rent-a-human/mechanical-ventilator/README.md

# mechanical-ventilator
Soporte Automatico para Emergencia Respiratoria
