rent-a-human/mechanical-ventilator/files/1.png

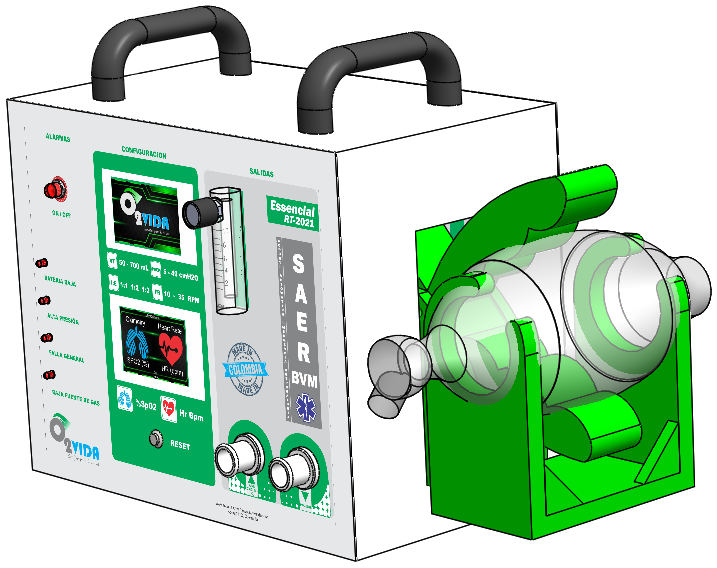
files/1.png
