rent-a-human/mechanical-ventilator/files/02 vida.png

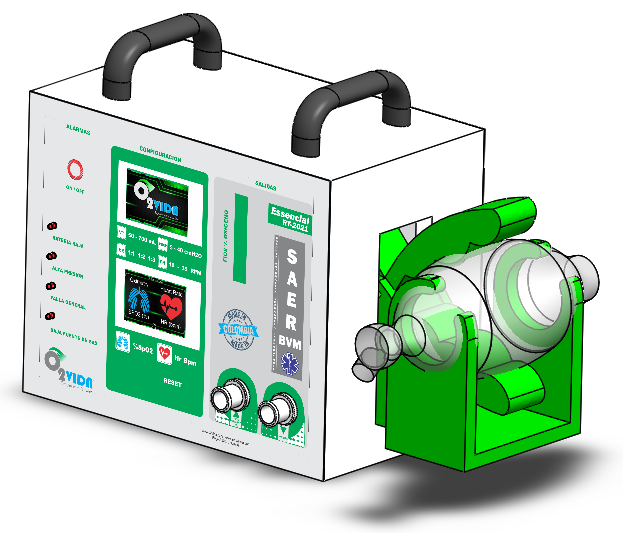
files/02 vida.png
