rent-a-human/mechanical-ventilator/files/02 vida_0.png

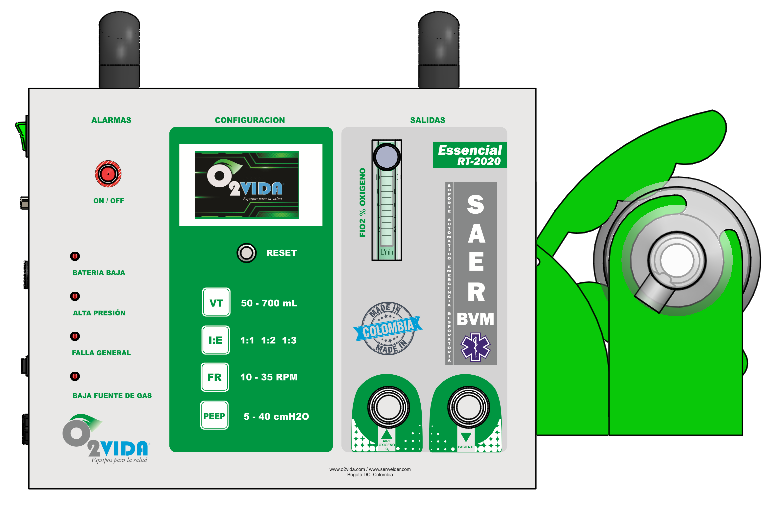
files/02 vida_0.png
