rent-a-human/mechanical-ventilator/files/02 vida_1.png

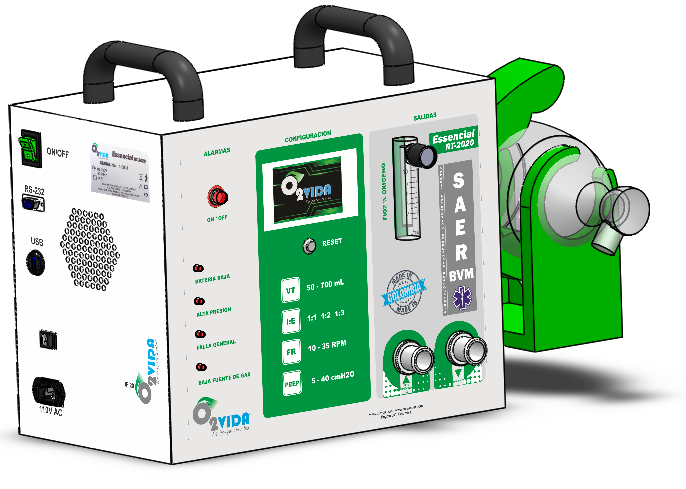
files/02 vida_1.png
