rent-a-human/mechanical-ventilator/files/02 vida_2.png

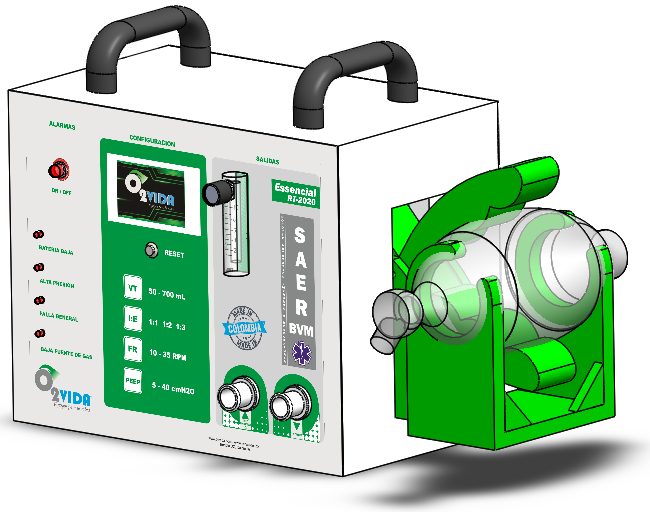
files/02 vida_2.png
