rent-a-human/mechanical-ventilator/files/2.png

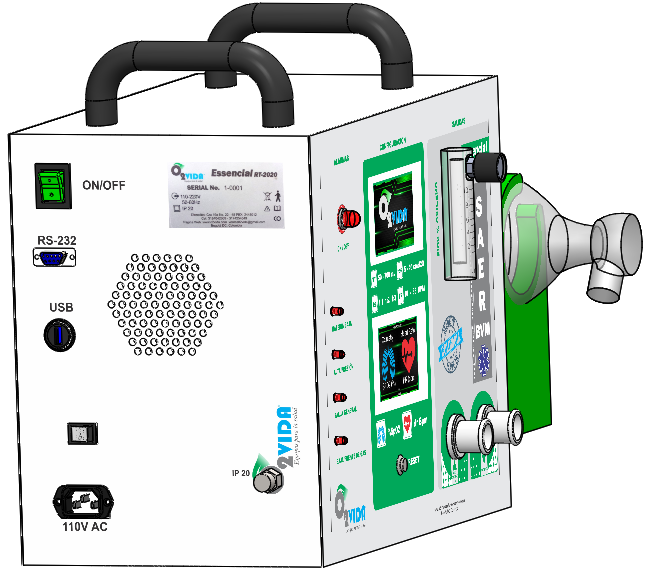
files/2.png
