rent-a-human/mechanical-ventilator/files/3.jpg

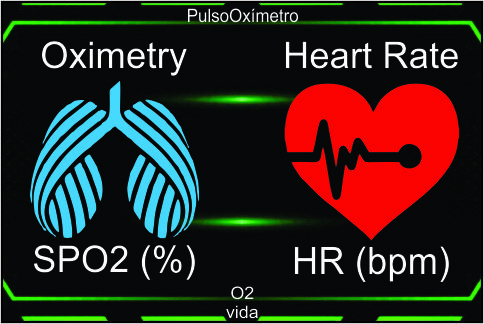
files/3.jpg
