rent-a-human/mechanical-ventilator/files/3.png

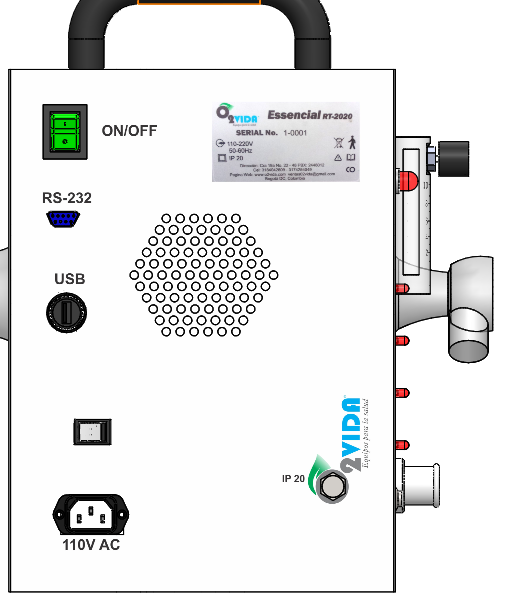
files/3.png
