rent-a-human/mechanical-ventilator/files/4.png

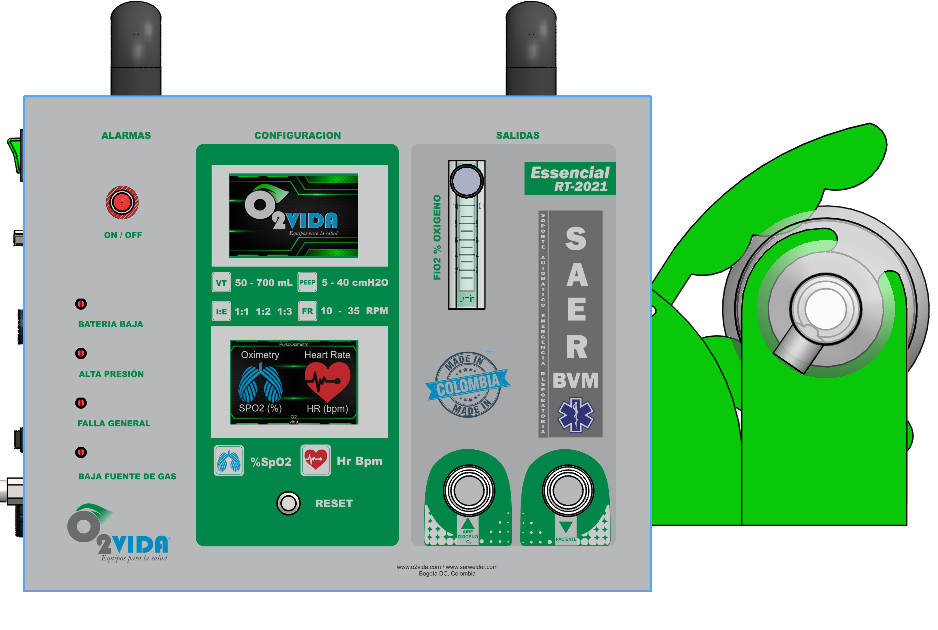
files/4.png
