rent-a-human/mechanical-ventilator/files/5.png

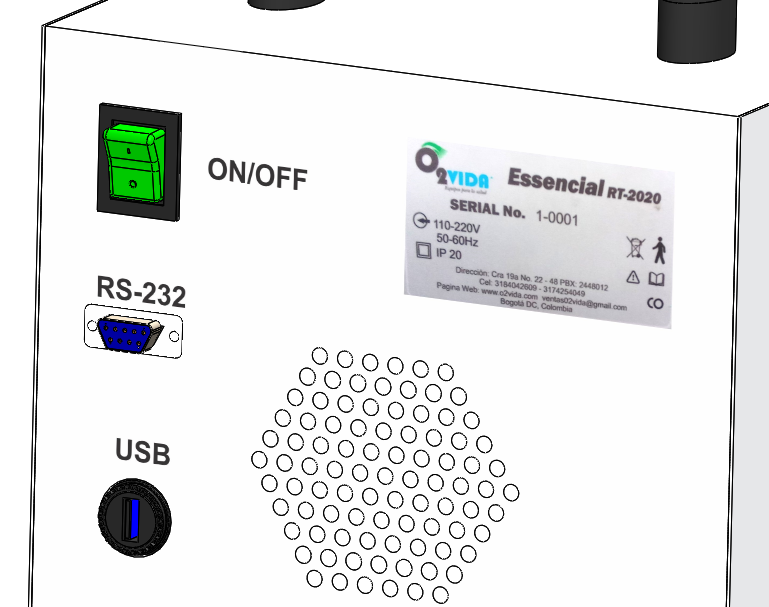
files/5.png
