rent-a-human/mechanical-ventilator/files/6.png

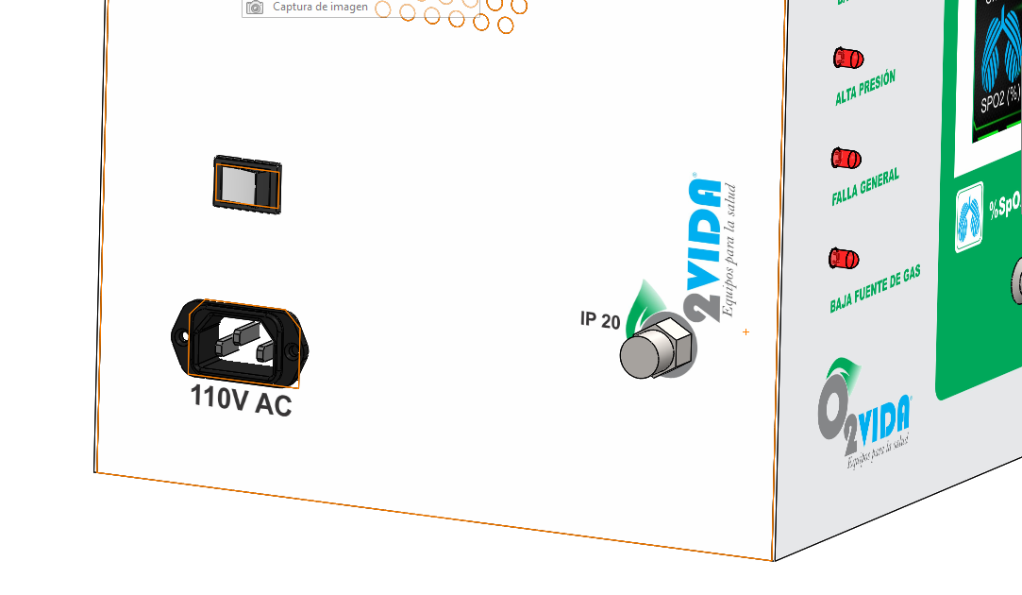
files/6.png
