rent-a-human/mechanical-ventilator/files/7.png

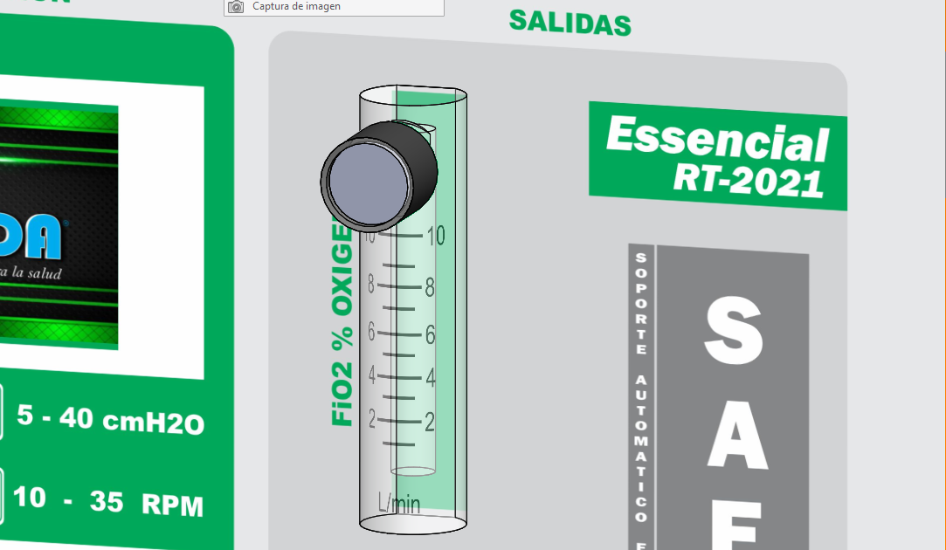
files/7.png
