rent-a-human/mechanical-ventilator/files/8.png

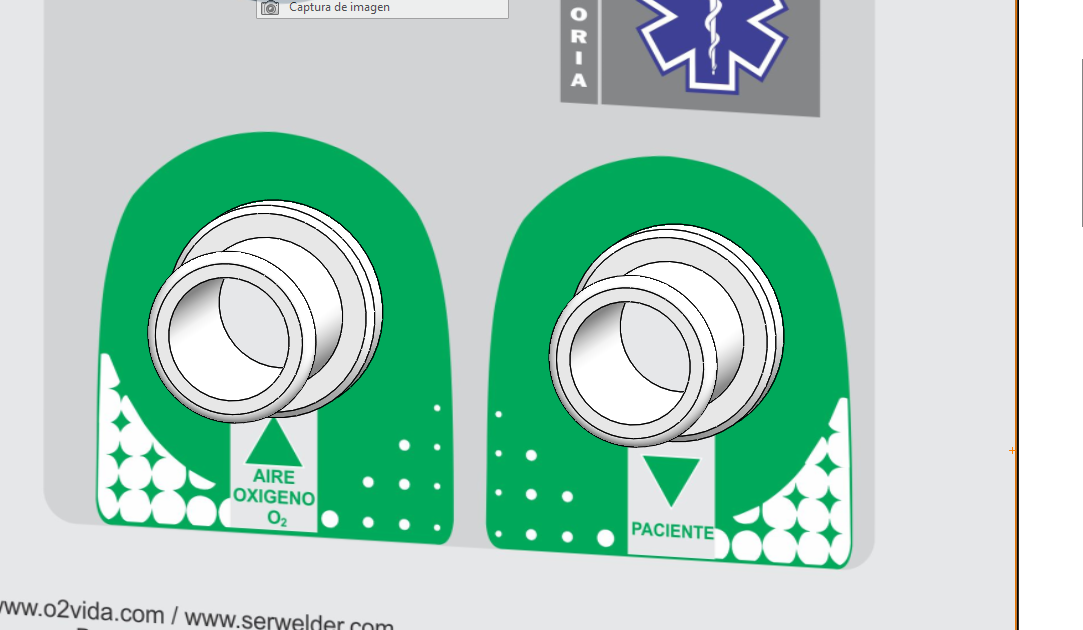
files/8.png
