rent-a-human/mechanical-ventilator/files/9.png

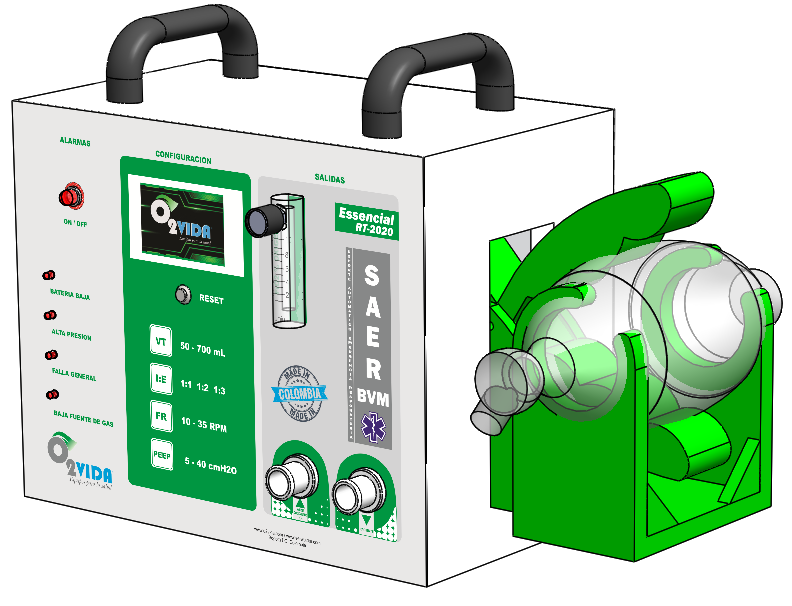
files/9.png
