rent-a-human/mechanical-ventilator/files/10.png

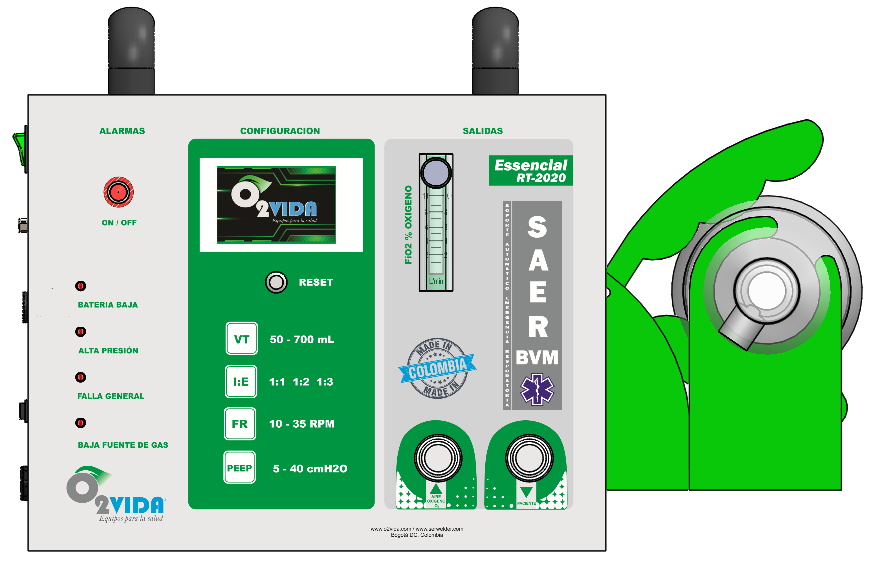
files/10.png
