rent-a-human/mechanical-ventilator/files/11.png

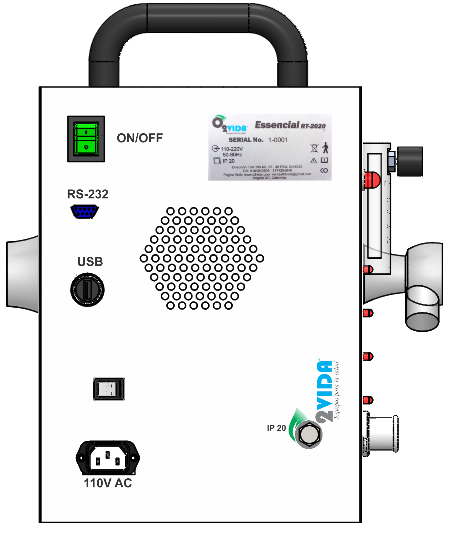
files/11.png
