rent-a-human/mechanical-ventilator/files/12.png

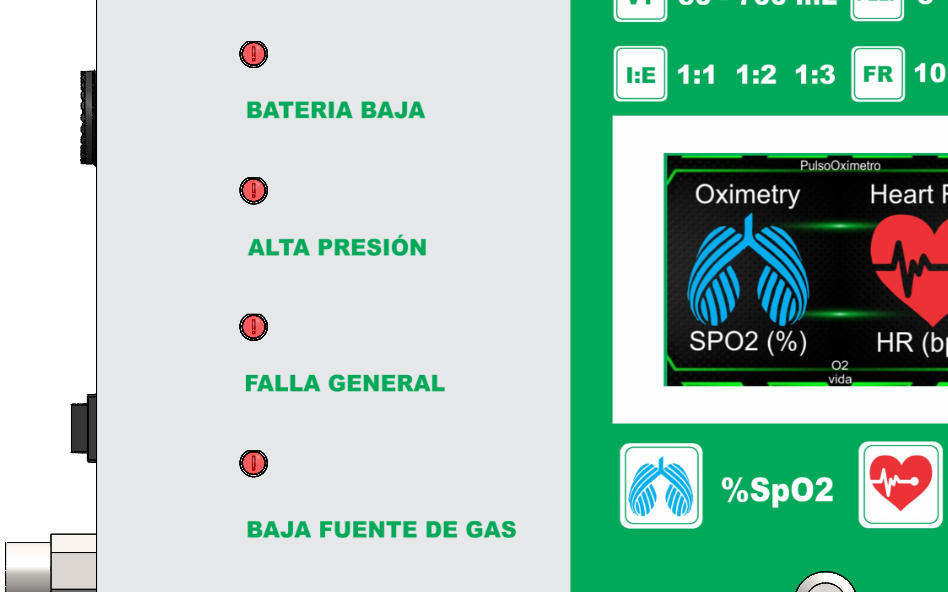
files/12.png
