rent-a-human/mechanical-ventilator/files/13.png

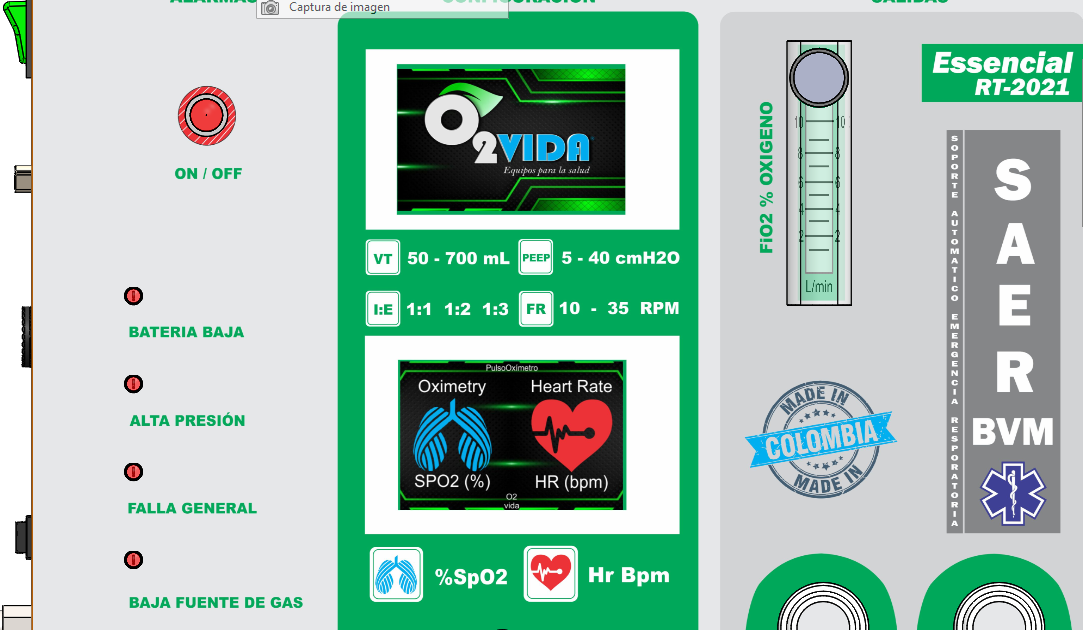
files/13.png
