rent-a-human/mechanical-ventilator/files/14.png

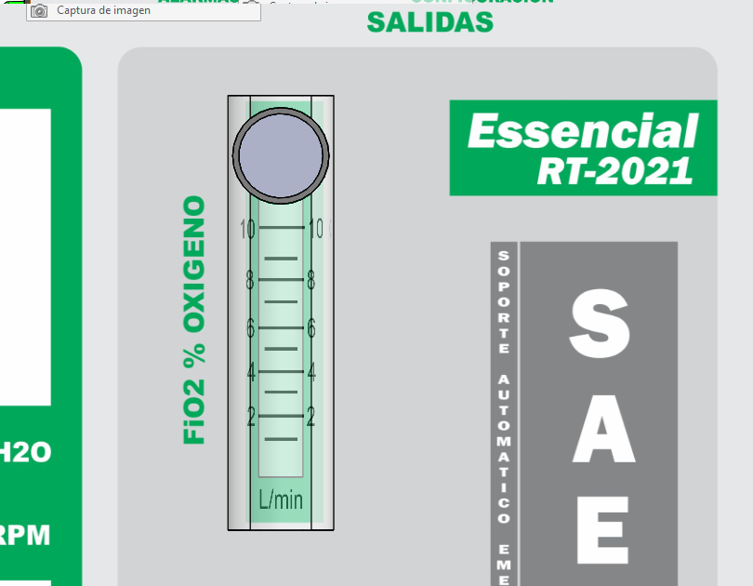
files/14.png
