rent-a-human/mechanical-ventilator/files/15.png

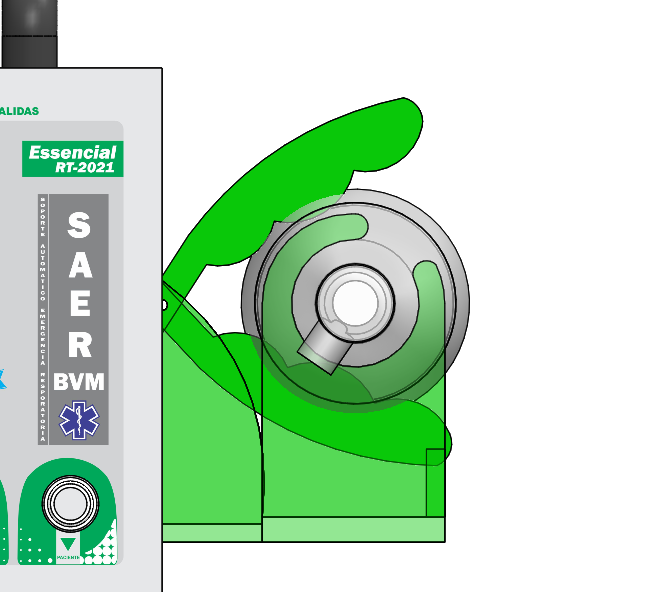
files/15.png
