rent-a-human/mechanical-ventilator/files/16.png

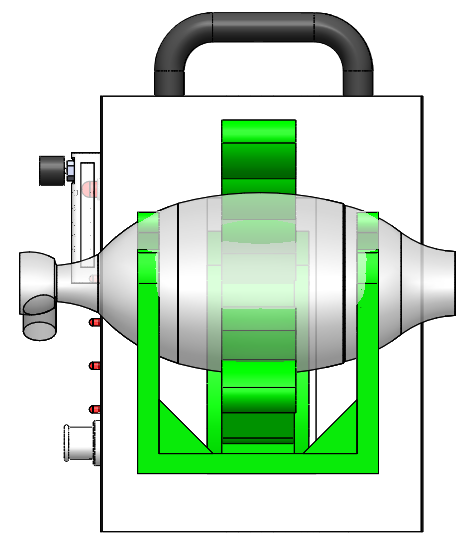
files/16.png
