rent-a-human/mechanical-ventilator/files/17.png

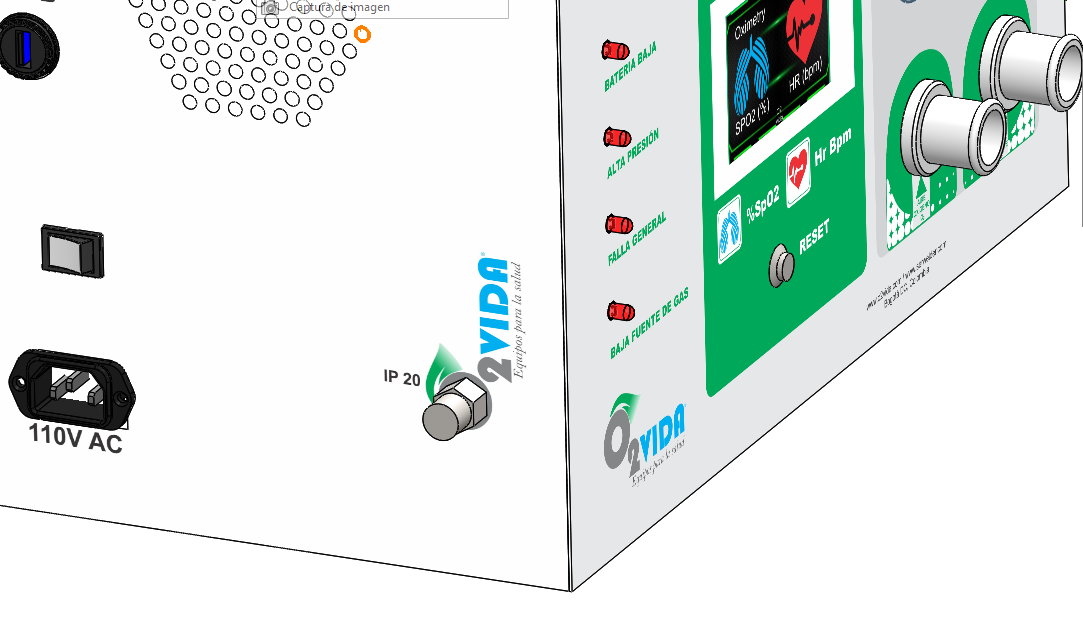
files/17.png
