rent-a-human/mechanical-ventilator/files/back1.png

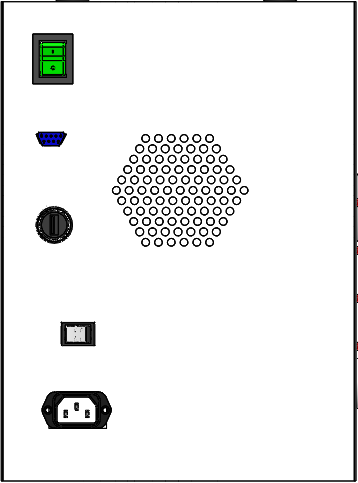
files/back1.png
