rent-a-human/mechanical-ventilator/files/frente_2.jpg

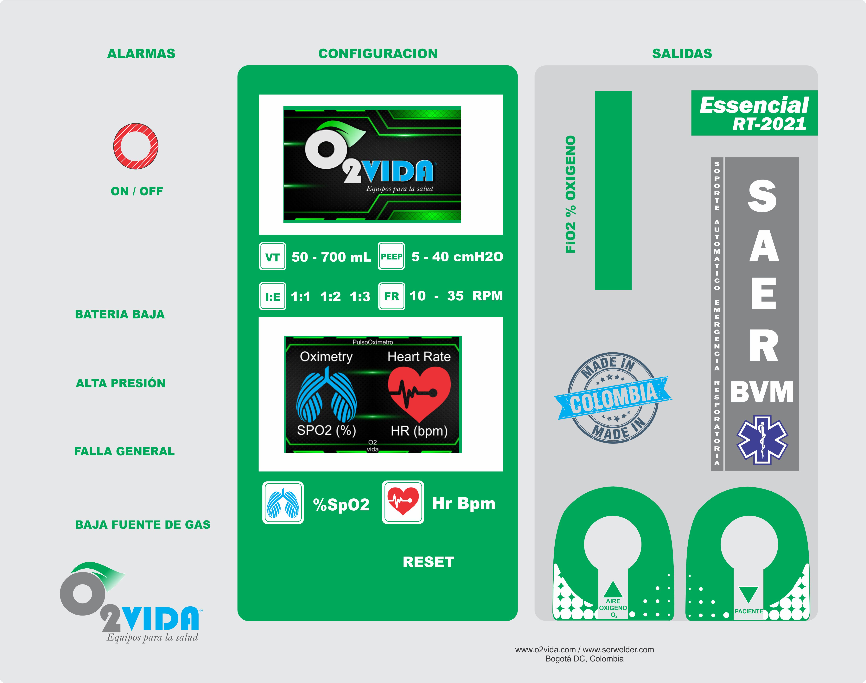
files/frente_2.jpg
