rent-a-human/mechanical-ventilator/files/frente_B.jpg

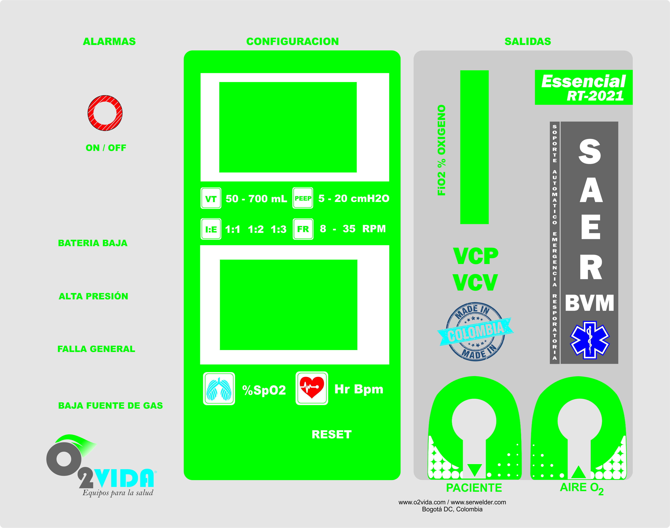
files/frente_B.jpg
