rent-a-human/mechanical-ventilator/files/RESPIRADOR/planos tarjeta/adelante2.PNG

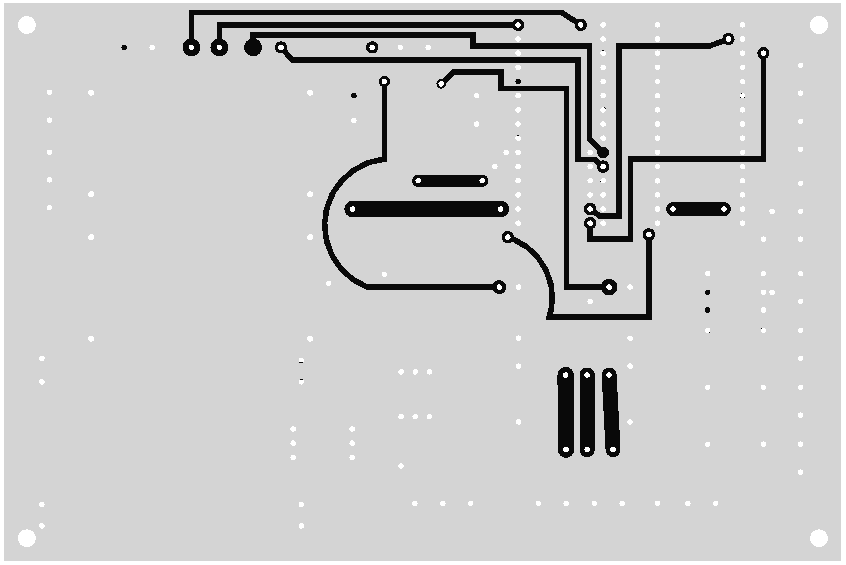
files/RESPIRADOR/planos tarjeta/adelante2.PNG
