rent-a-human/mechanical-ventilator/files/RESPIRADOR/planos tarjeta/atras_jpg.JPG

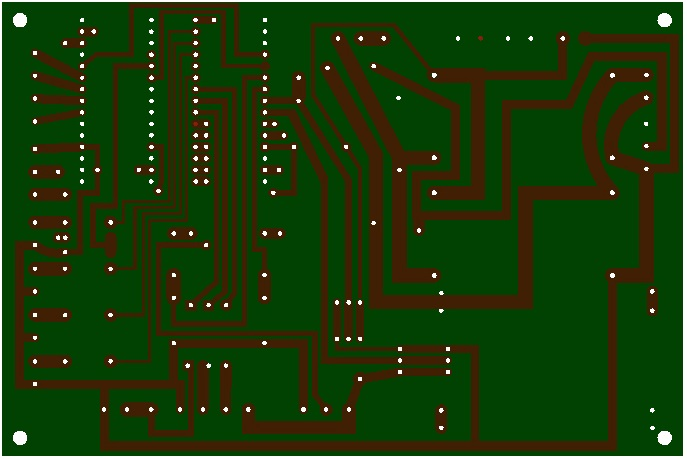
files/RESPIRADOR/planos tarjeta/atras_jpg.JPG
