rent-a-human/mechanical-ventilator/files/RESPIRADOR/planos tarjeta/atras_solo.PNG

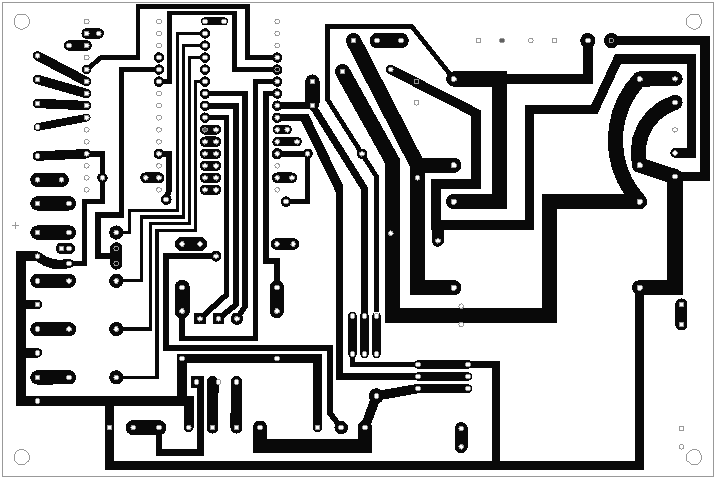
files/RESPIRADOR/planos tarjeta/atras_solo.PNG
