rent-a-human/mechanical-ventilator/files/ROTA1.png

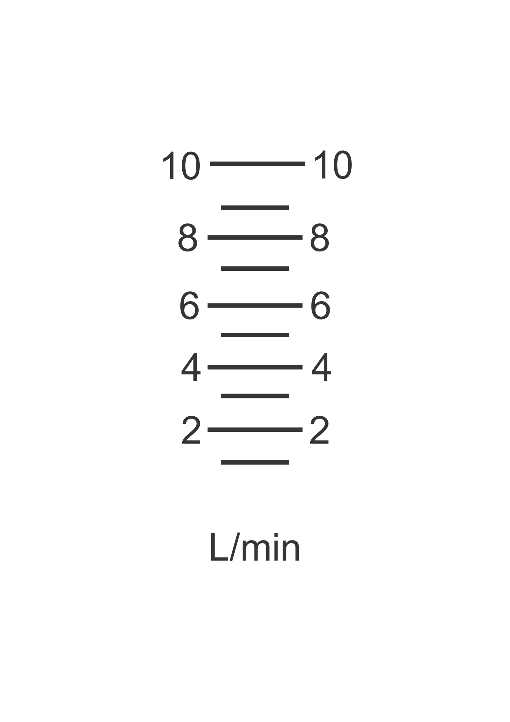
files/ROTA1.png
