rent-a-human/mechanical-ventilator/files/rotametro.jpg

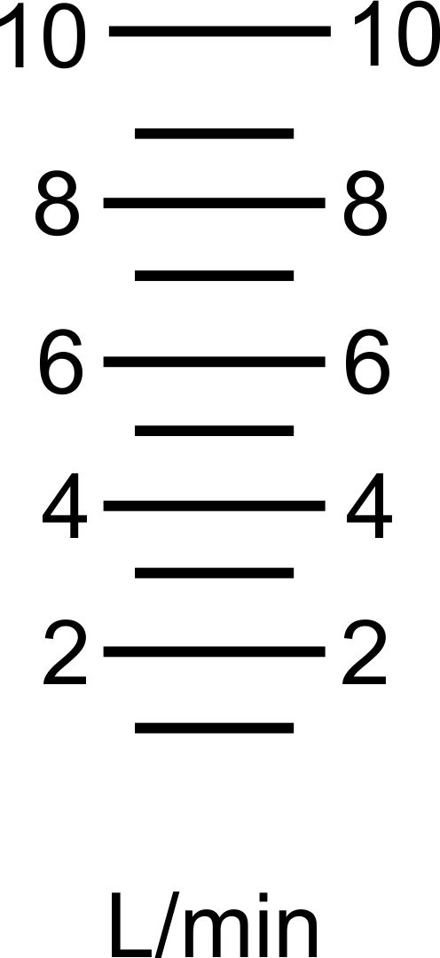
files/rotametro.jpg
