rent-a-human/mechanical-ventilator/files/On off switch.SLDASM

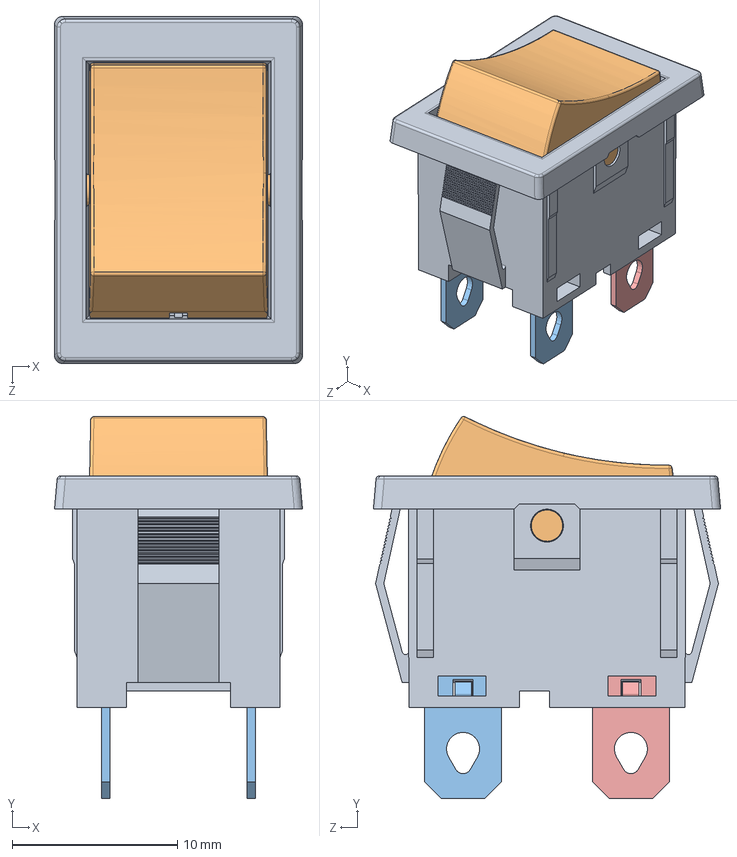
[picture p35: CAD file, 2021-10-17]
files/On off switch.SLDASM
15.0 x 23.1 x 21.0 mm
On off switch base
On off switch button
On off switch pin2 x 2
On off switch pin1
On off switch pin3
On off switch click
On off switch spring
