rent-a-human/mechanical-ventilator/files/Ensamblaje1.SLDASM

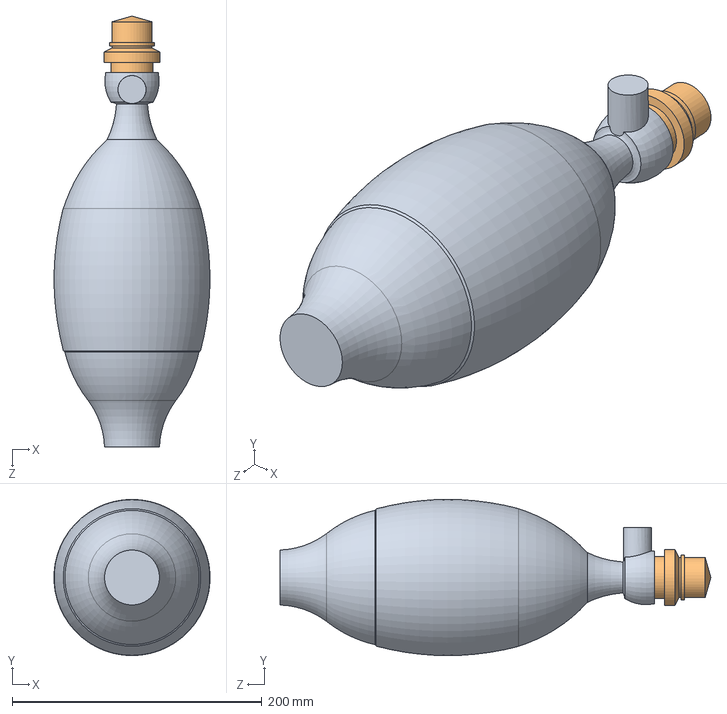
[picture p36: CAD file, 2021-10-17]
files/Ensamblaje1.SLDASM
124.9 x 125.1 x 345.0 mm
ambu
peep
