rent-a-human/mechanical-ventilator/files/Ensamblaje_Respirador_1_pantalla.SLDASM

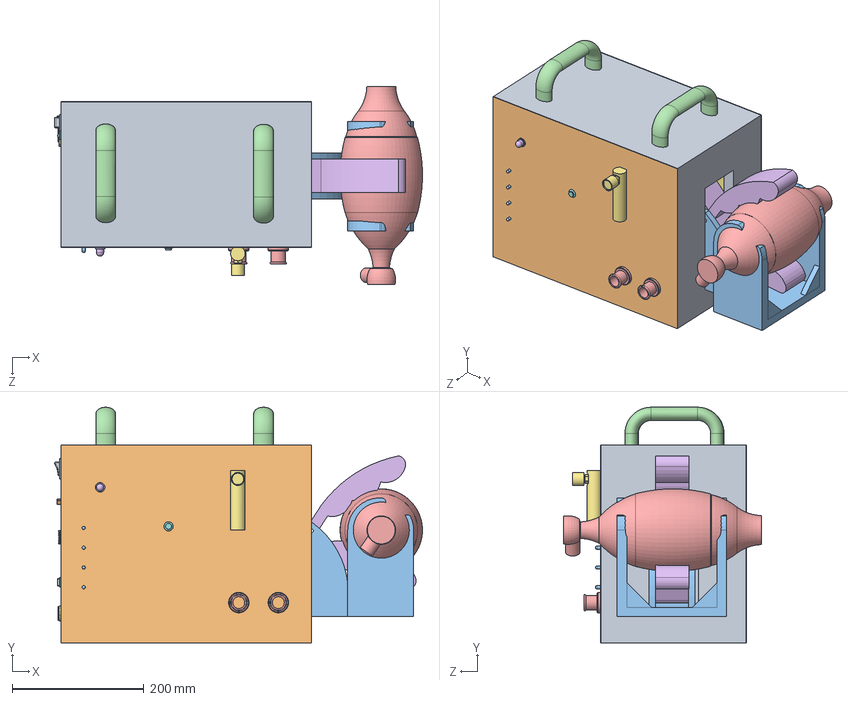
[picture p37: CAD file, 2021-10-17]
files/Ensamblaje_Respirador_1_pantalla.SLDASM
558.3 x 357.5 x 300.0 mm
cajon
tapa_1
base_ambu
manija x 2
ambu
pinza x 2
tapa
On off switch base
On off switch button
On off switch pin2 x 2
On off switch pin1
On off switch pin3
On off switch click
On off switch spring
AC Male Socket PC v7
USB3 FTV 2X_ USB TYPE
KCD4_ROCKET_SWITCH
RS232 Female
LED5mmBody x 4
LED5mmLeg x 4
Acople x 2
piloto
ROTAMETRO
reset_buton
