rent-a-human/mechanical-ventilator/files/Ensamblaje_Pinza_Motores.SLDASM

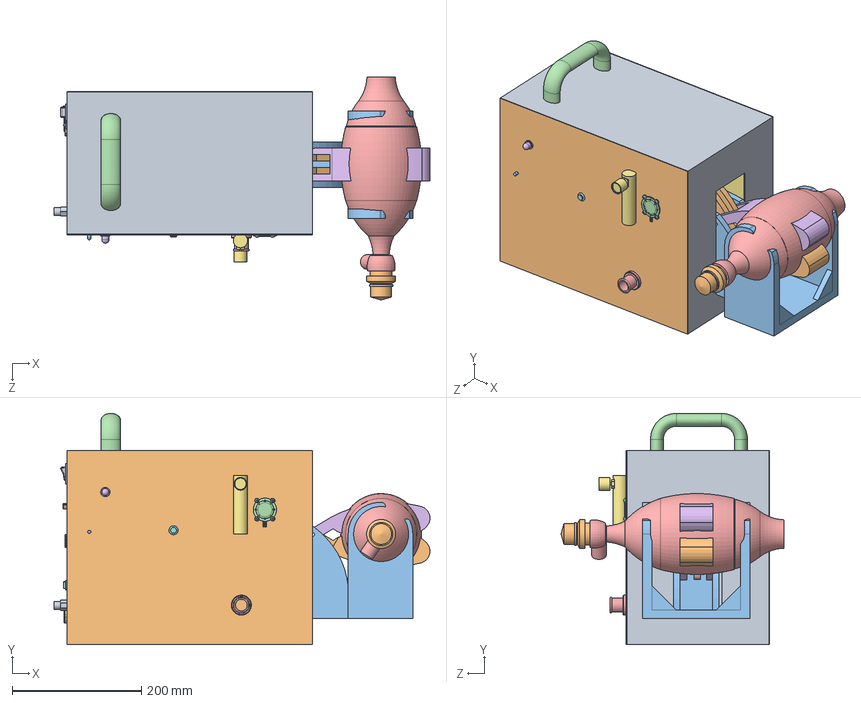
[picture p38: CAD file, 2021-10-17]
files/Ensamblaje_Pinza_Motores.SLDASM
581.6 x 357.5 x 345.0 mm
base_ambu
pinza
Soporte Biela Tuerca
Biela x 2
42BYGH0425 x 2
8mm ID 10mm OD Lead Screw
Trapezoidal lead screw 90mm
acople flexible x 2
pinza inferior
