rent-a-human/mechanical-ventilator/files/RESPIRADOR/planos tarjeta/atras_y_adelante.DXF

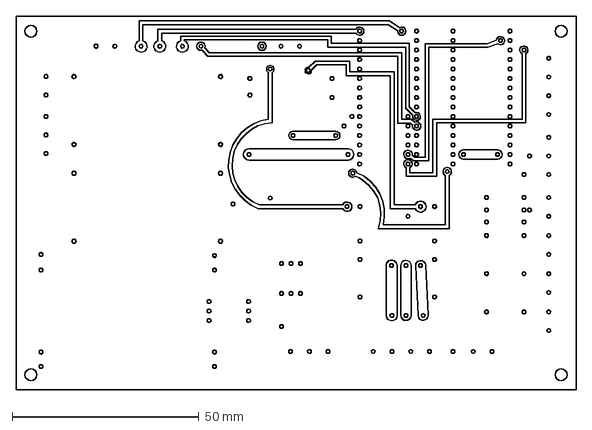
[picture p39: CAD file, 2021-10-17]
files/RESPIRADOR/planos tarjeta/atras_y_adelante.DXF
150.0 x 100.0 mm
