rent-a-human/mechanical-ventilator/files/Manguera Filtro Mascara.SLDPRT

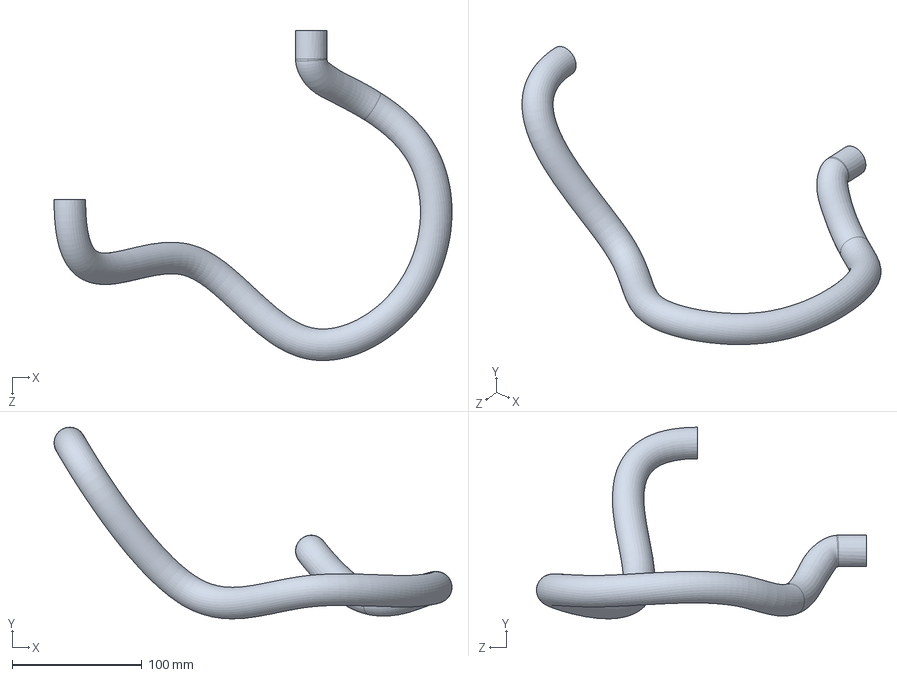
[picture p40: CAD file, 2021-10-17]
files/Manguera Filtro Mascara.SLDPRT
306.5 x 147.6 x 254.2 mm
