rent-a-human/mechanical-ventilator/files/RESPIRADOR/planos tarjeta/baquela.DXF

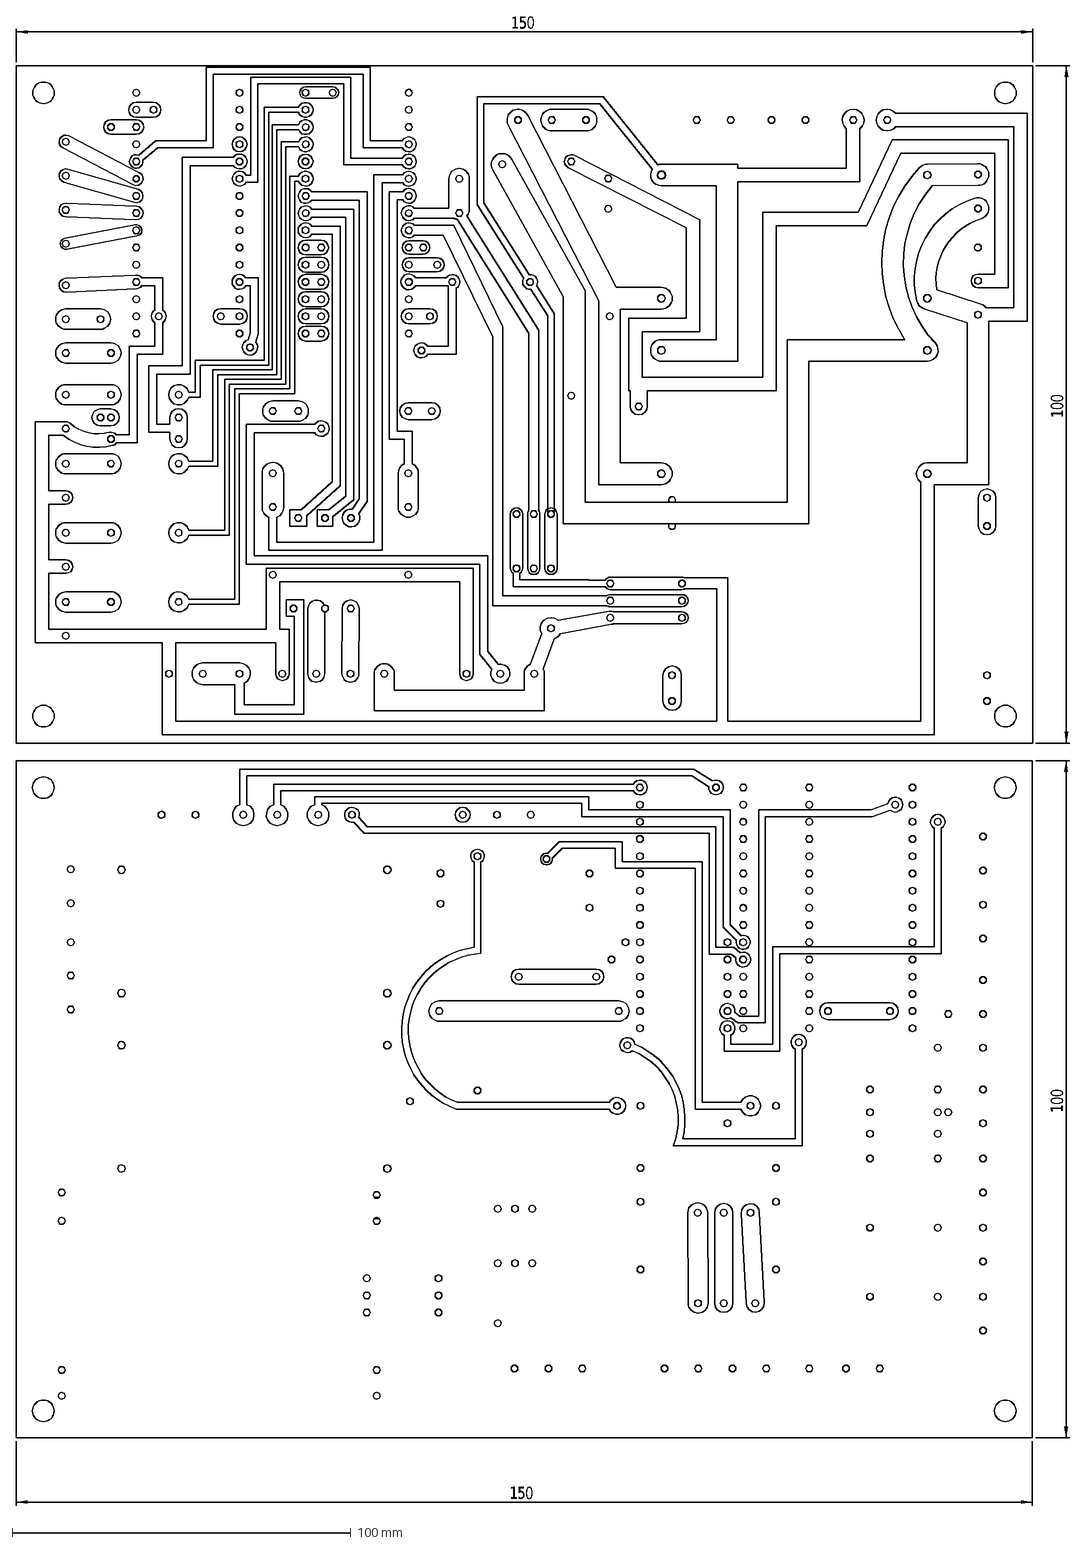
[picture p41: CAD file, 2021-10-17]
files/RESPIRADOR/planos tarjeta/baquela.DXF
150
100
