rent-a-human/mechanical-ventilator/files/conector_o2.SLDPRT

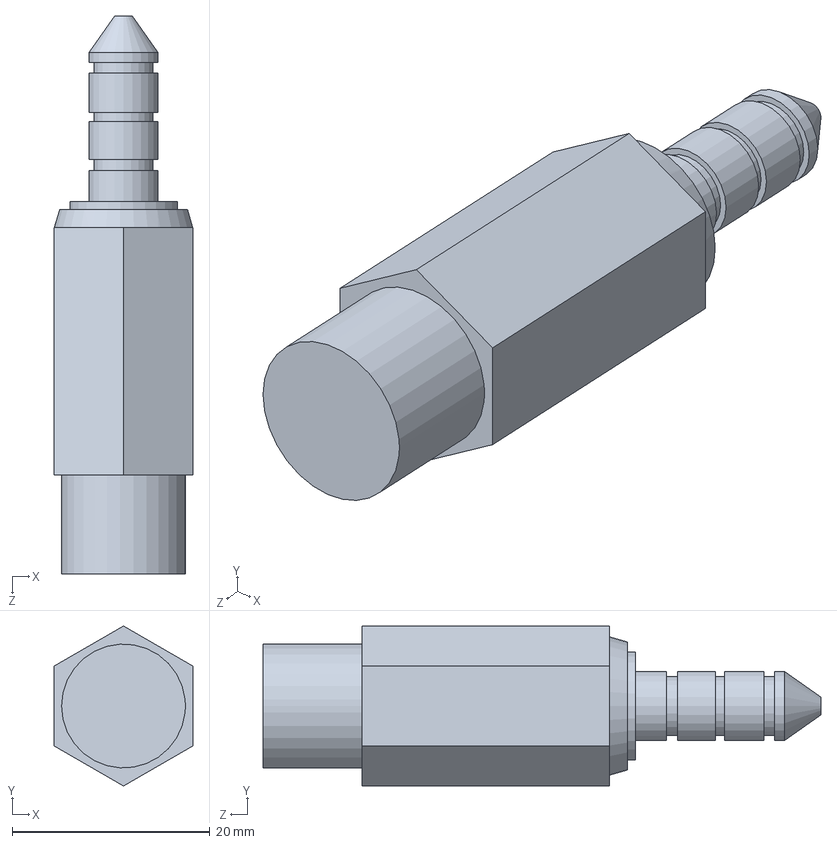
[picture p42: CAD file, 2021-10-17]
files/conector_o2.SLDPRT
14.0 x 16.2 x 56.4 mm
