rent-a-human/mechanical-ventilator/files/Manguera Filtro Mascara Paciente 2.SLDPRT

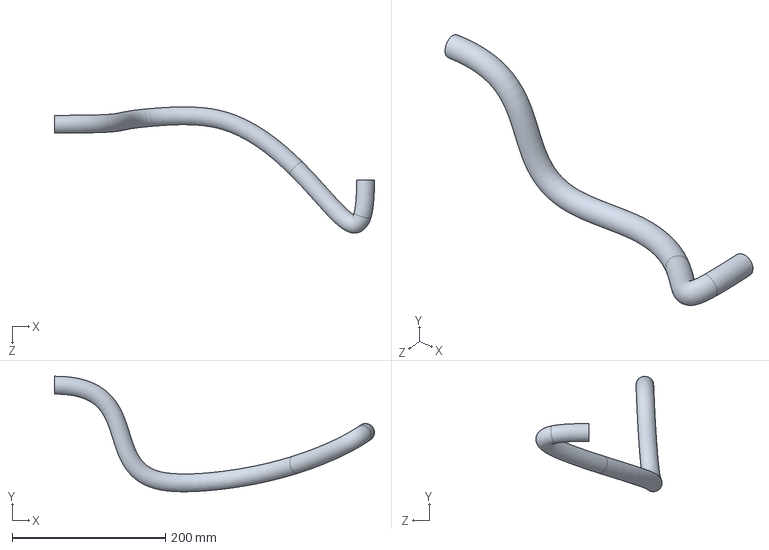
[picture p43: CAD file, 2021-10-17]
files/Manguera Filtro Mascara Paciente 2.SLDPRT
417.6 x 150.8 x 164.8 mm
