rent-a-human/mechanical-ventilator/files/Sensor_Pesion.SLDPRT

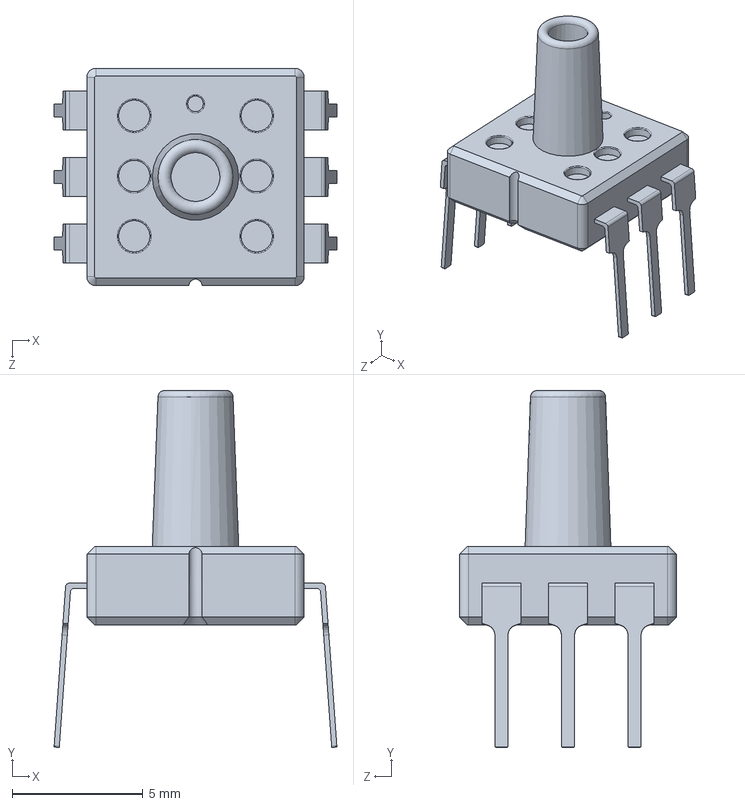
[picture p44: CAD file, 2021-10-17]
files/Sensor_Pesion.SLDPRT
10.8 x 13.6 x 8.30 mm
