rent-a-human/mechanical-ventilator/files/tapa.SLDPRT

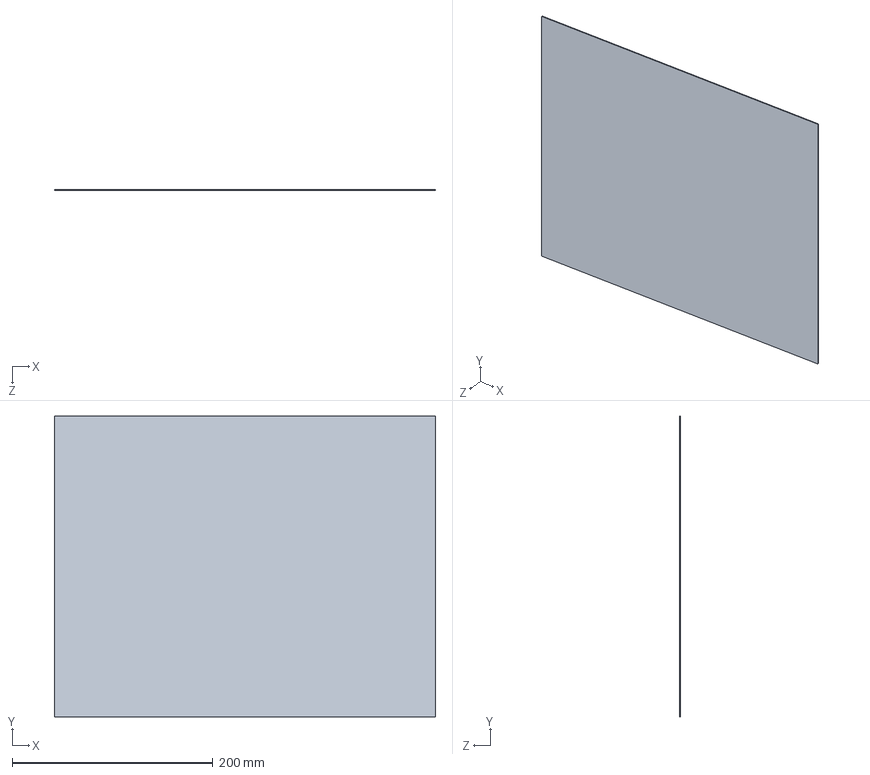
[picture p45: CAD file, 2021-10-17]
files/tapa.SLDPRT
380.0 x 300.0 x 1.00 mm
