rent-a-human/mechanical-ventilator/files/Mascara.SLDPRT

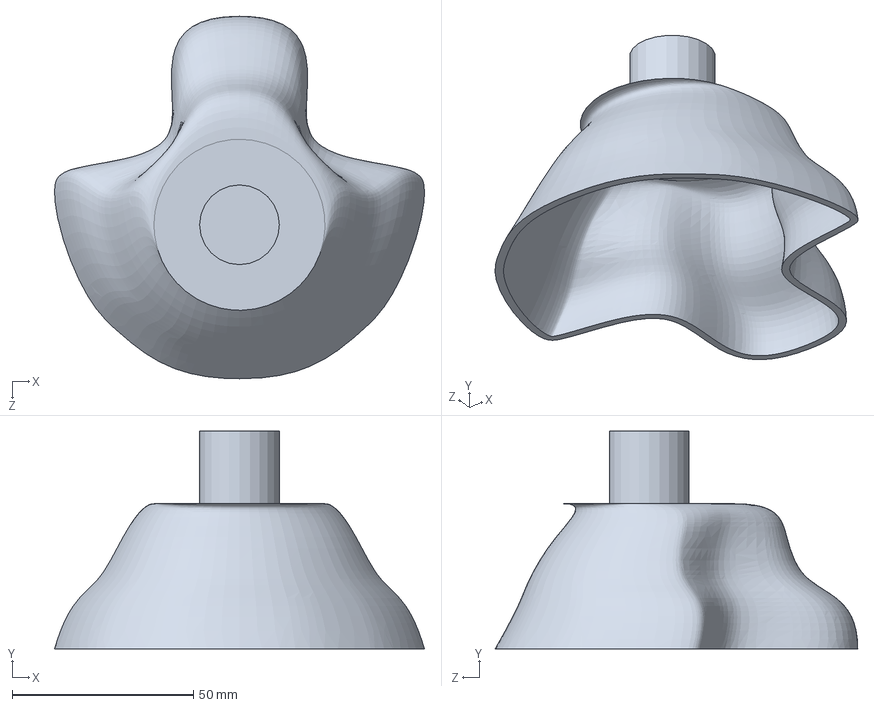
[picture p46: CAD file, 2021-10-17]
files/Mascara.SLDPRT
102.1 x 60.0 x 100.0 mm
