rent-a-human/mechanical-ventilator/files/Manguera_2_O2_2.SLDPRT

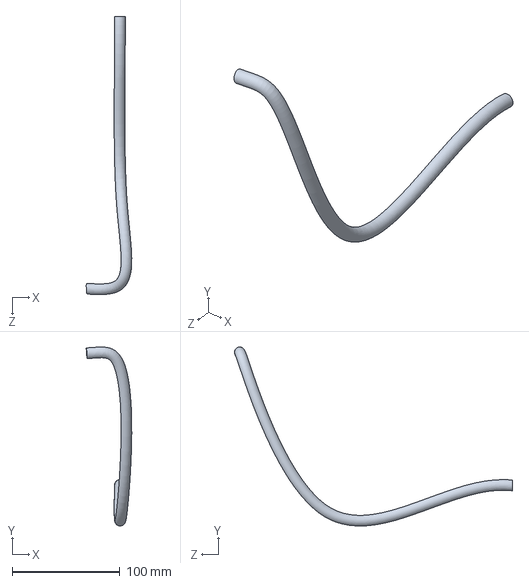
[picture p47: CAD file, 2021-10-17]
files/Manguera_2_O2_2.SLDPRT
42.3 x 166.4 x 258.6 mm
