rent-a-human/mechanical-ventilator/files/peep.SLDPRT

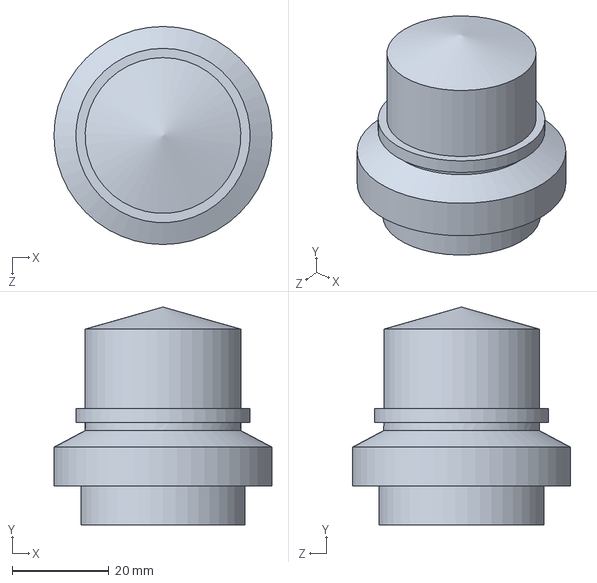
[picture p48: CAD file, 2021-10-17]
files/peep.SLDPRT
45.0 x 45.0 x 45.0 mm
