rent-a-human/mechanical-ventilator/files/conector_o2_out.SLDPRT

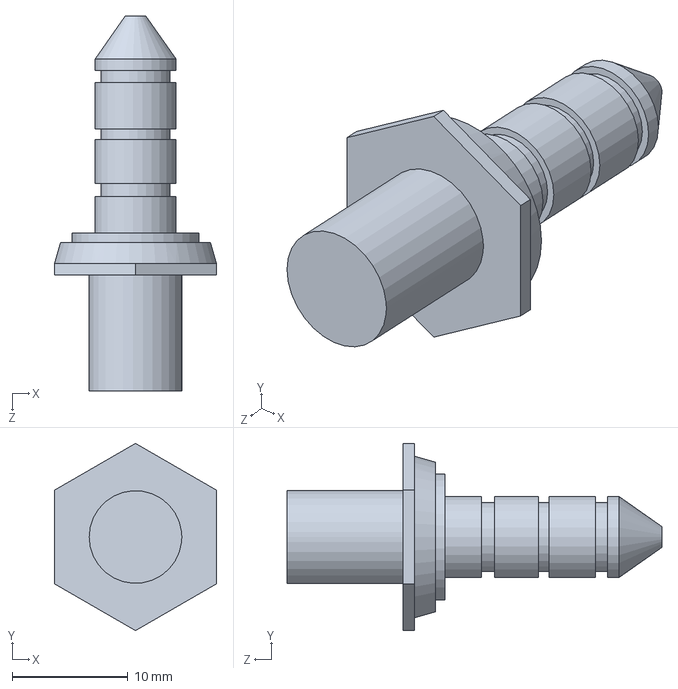
[picture p49: CAD file, 2021-10-17]
files/conector_o2_out.SLDPRT
14.0 x 16.2 x 32.4 mm
