rent-a-human/mechanical-ventilator/files/Filtro de Aire.SLDPRT

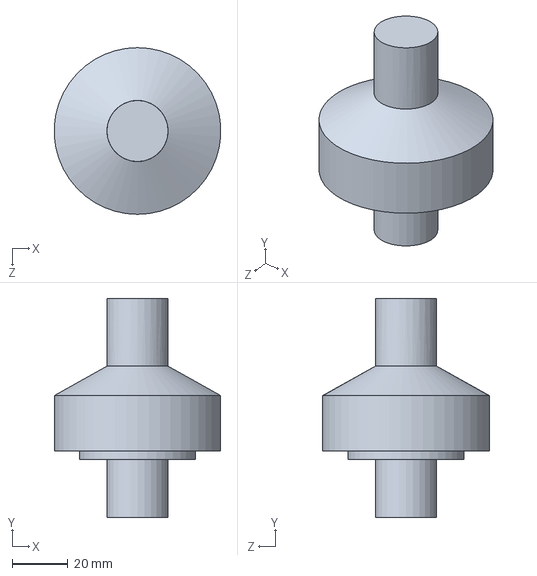
[picture p50: CAD file, 2021-10-17]
files/Filtro de Aire.SLDPRT
59.9 x 78.8 x 60.0 mm
