rent-a-human/mechanical-ventilator/files/Manguera_02_Externa.SLDPRT

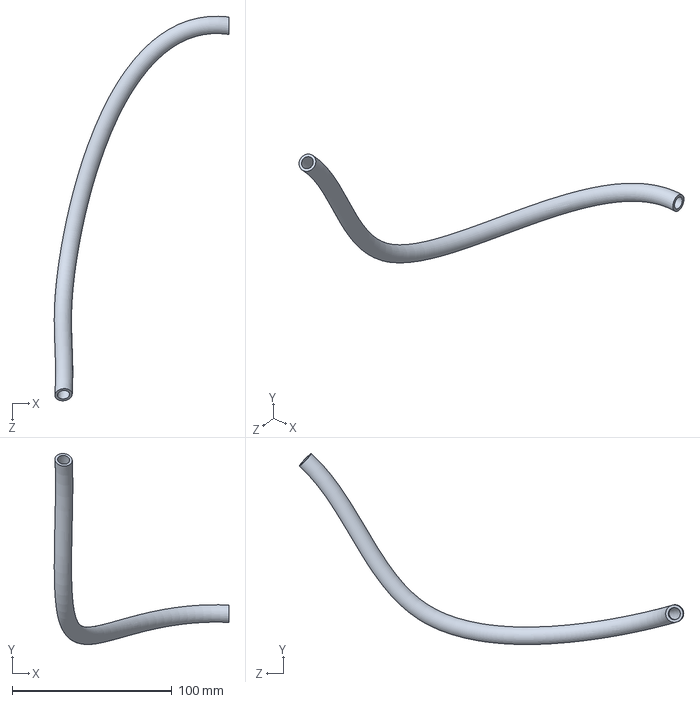
[picture p51: CAD file, 2021-10-17]
files/Manguera_02_Externa.SLDPRT
109.2 x 119.5 x 240.5 mm
