rent-a-human/mechanical-ventilator/files/pinza.SLDPRT

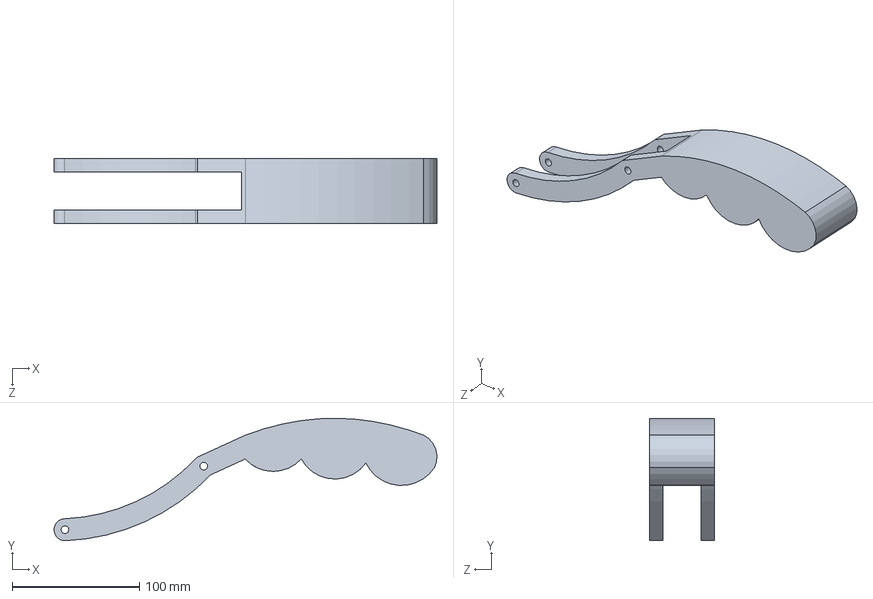
[picture p52: CAD file, 2021-10-17]
files/pinza.SLDPRT
301.1 x 96.2 x 51.0 mm
