rent-a-human/mechanical-ventilator/files/Biela.SLDPRT

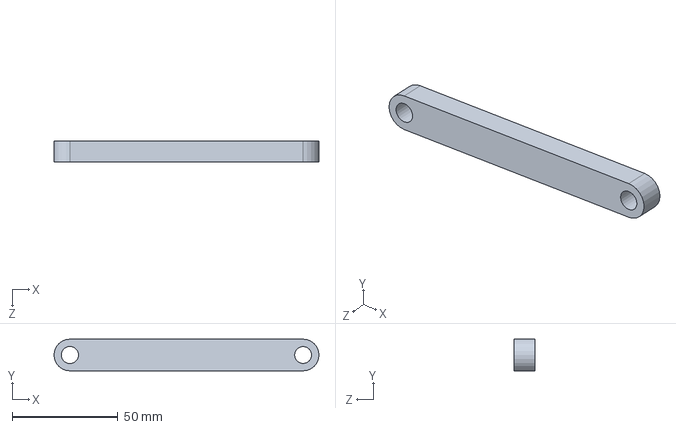
[picture p53: CAD file, 2021-10-17]
files/Biela.SLDPRT
125.0 x 15.0 x 10.0 mm
