rent-a-human/mechanical-ventilator/files/Base.SLDPRT

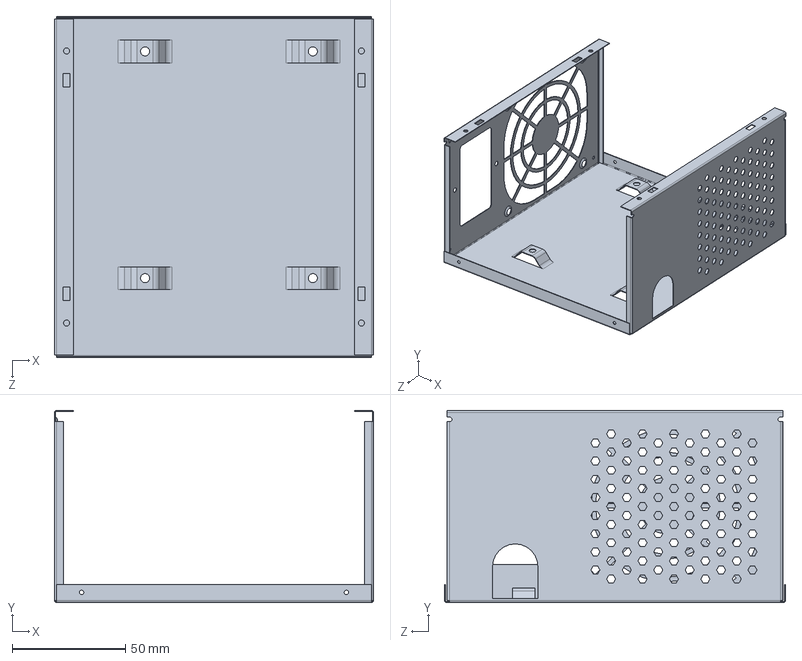
[picture p54: CAD file, 2021-10-17]
files/Base.SLDPRT
140.8 x 84.8 x 150.4 mm
