rent-a-human/mechanical-ventilator/files/piloto.SLDPRT

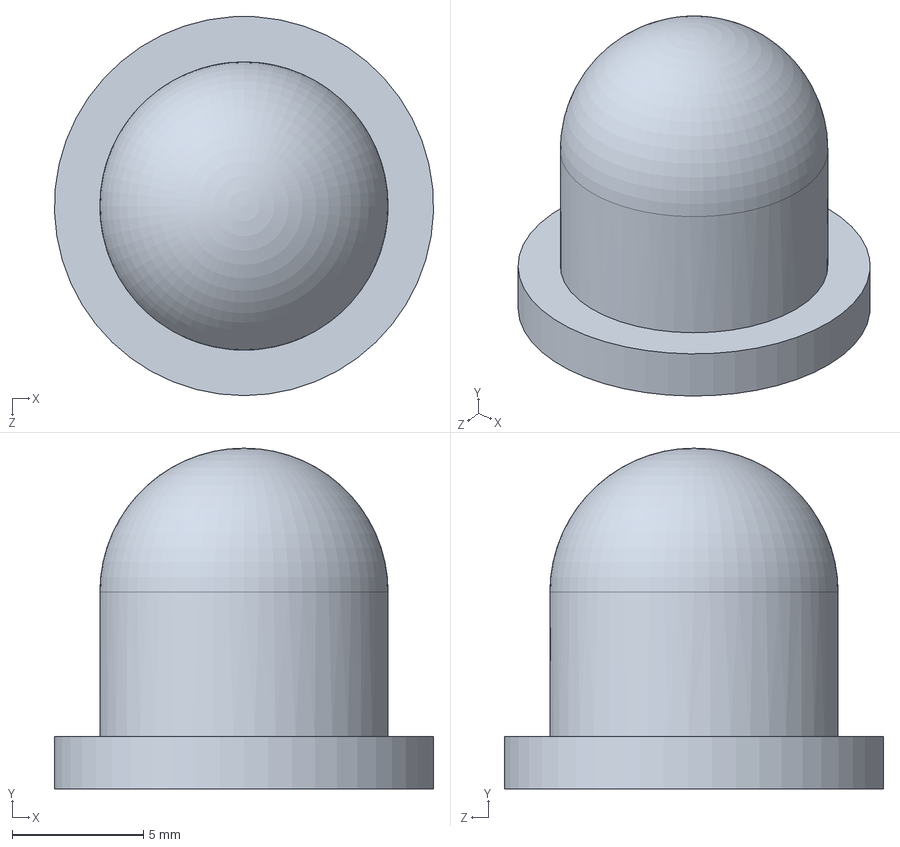
[picture p55: CAD file, 2021-10-17]
files/piloto.SLDPRT
14.5 x 13.0 x 14.5 mm
