rent-a-human/mechanical-ventilator/files/Manguera_2_O2.SLDPRT

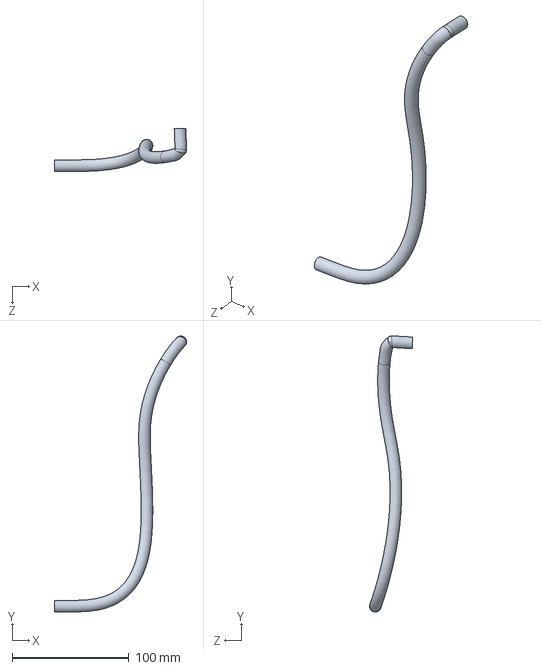
[picture p56: CAD file, 2021-10-17]
files/Manguera_2_O2.SLDPRT
113.5 x 236.8 x 36.9 mm
