rent-a-human/mechanical-ventilator/files/cajon.SLDPRT

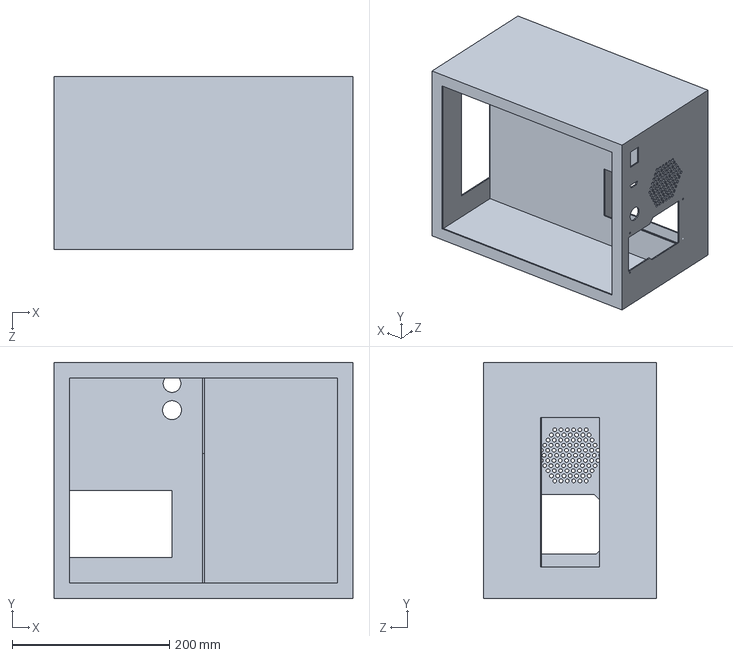
[picture p57: CAD file, 2021-10-17]
files/cajon.SLDPRT
380.0 x 300.0 x 220.0 mm
