rent-a-human/mechanical-ventilator/files/Manguera_2.sldprt

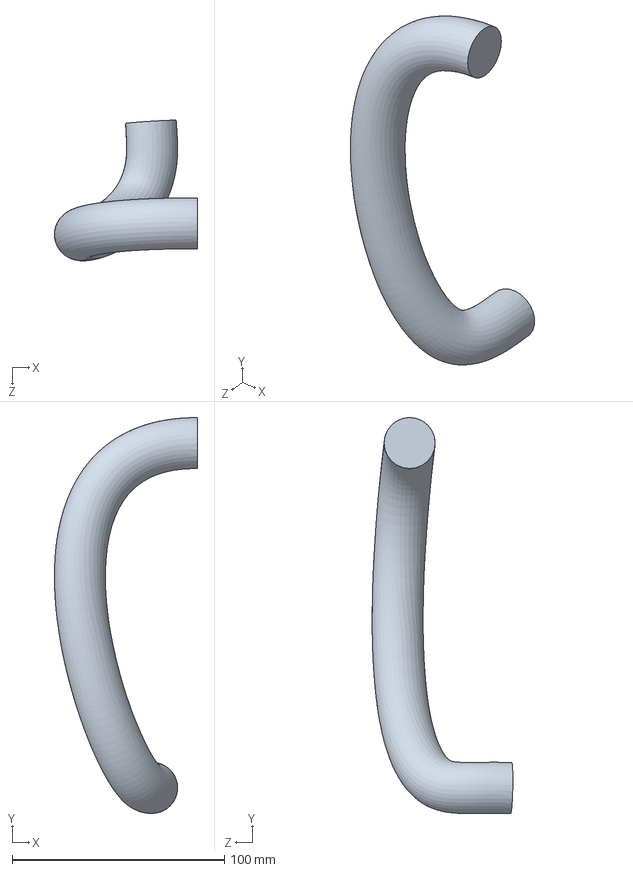
[picture p58: CAD file, 2021-10-17]
files/Manguera_2.sldprt
67.5 x 186.7 x 66.4 mm
