rent-a-human/mechanical-ventilator/files/Reservorio.SLDPRT

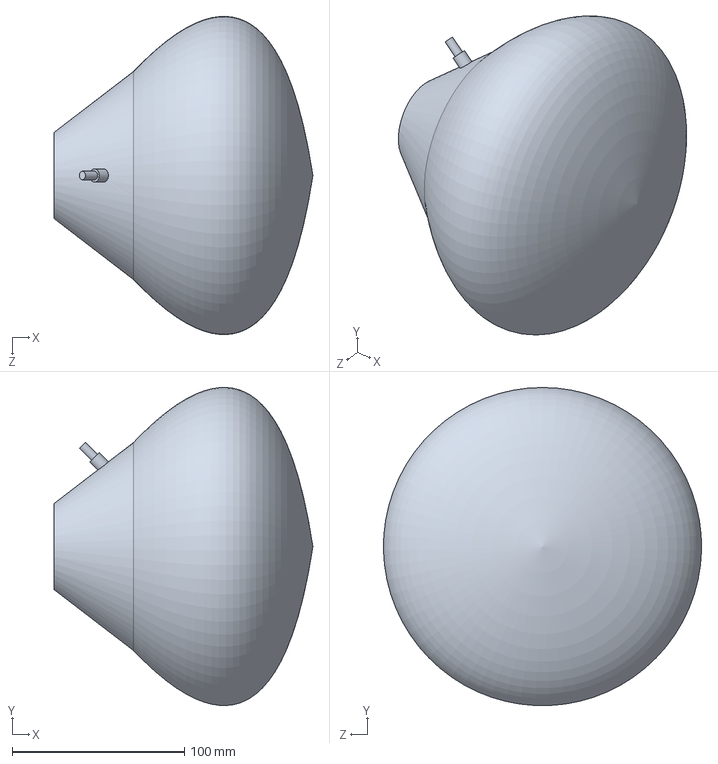
[picture p59: CAD file, 2021-10-17]
files/Reservorio.SLDPRT
150.2 x 184.5 x 184.6 mm
