rent-a-human/mechanical-ventilator/files/Acople.SLDPRT

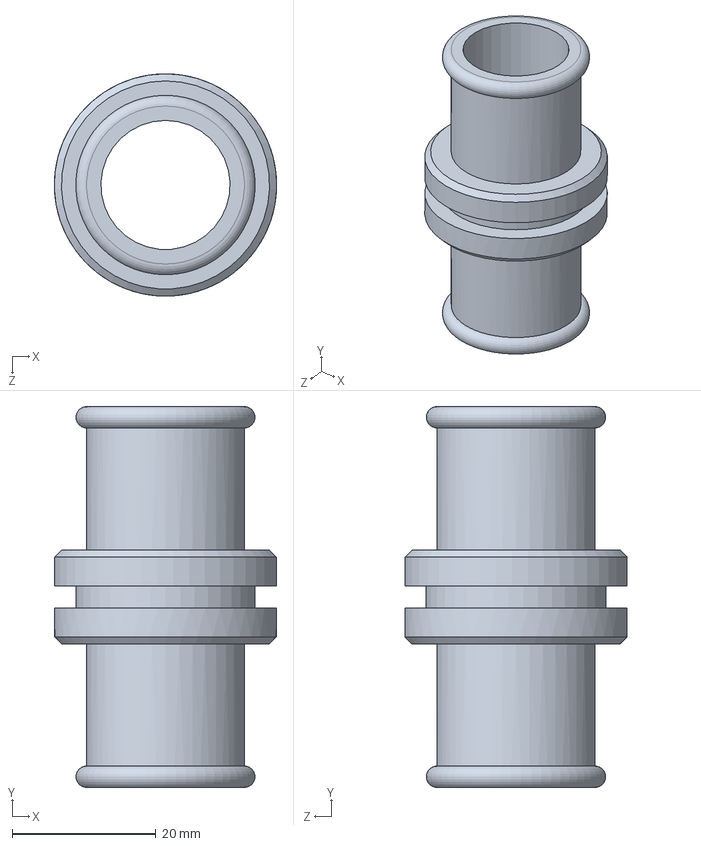
[picture p60: CAD file, 2021-10-17]
files/Acople.SLDPRT
31.0 x 53.1 x 31.0 mm
