rent-a-human/mechanical-ventilator/files/Soporte Biela Tuerca.SLDPRT

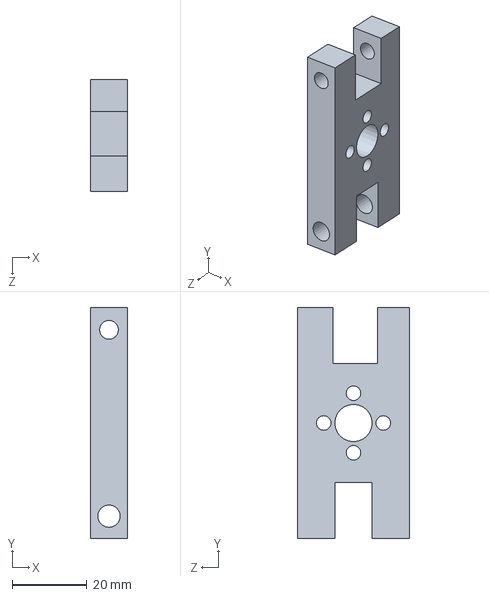
[picture p61: CAD file, 2021-10-17]
files/Soporte Biela Tuerca.SLDPRT
10.0 x 62.0 x 30.0 mm
