rent-a-human/mechanical-ventilator/files/ROTAMETRO.SLDPRT

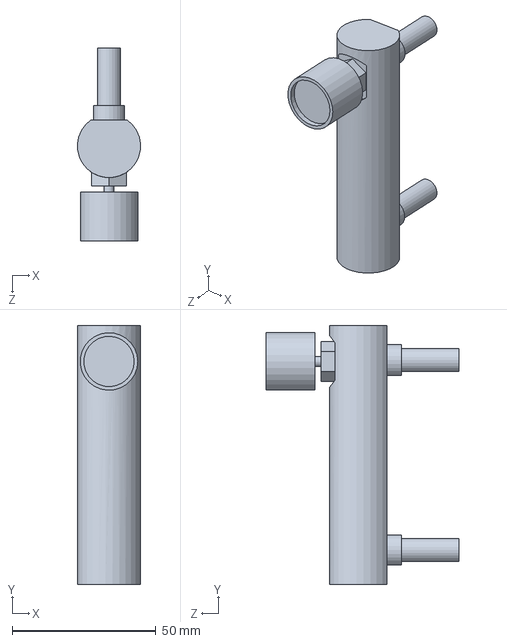
[picture p62: CAD file, 2021-10-17]
files/ROTAMETRO.SLDPRT
21.9 x 90.0 x 67.0 mm
