rent-a-human/mechanical-ventilator/files/base_ambu.SLDPRT

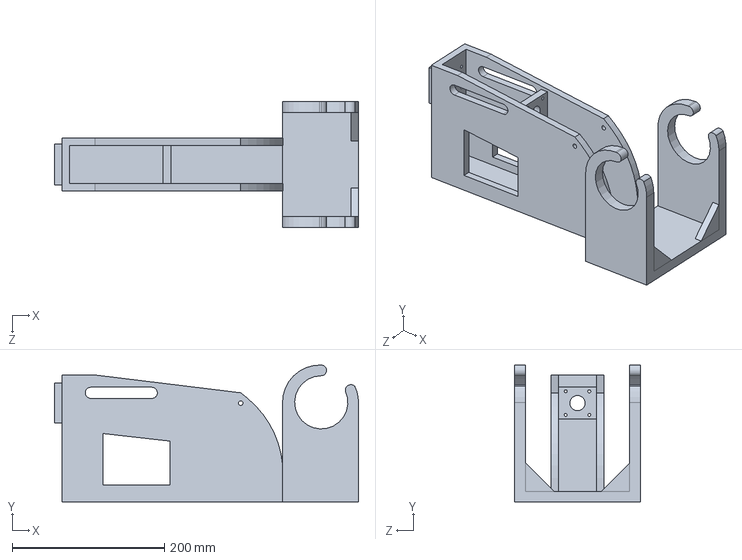
[picture p63: CAD file, 2021-10-17]
files/base_ambu.SLDPRT
400.0 x 180.0 x 166.0 mm
