rent-a-human/mechanical-ventilator/files/Acople_Sensor_Presion.SLDPRT

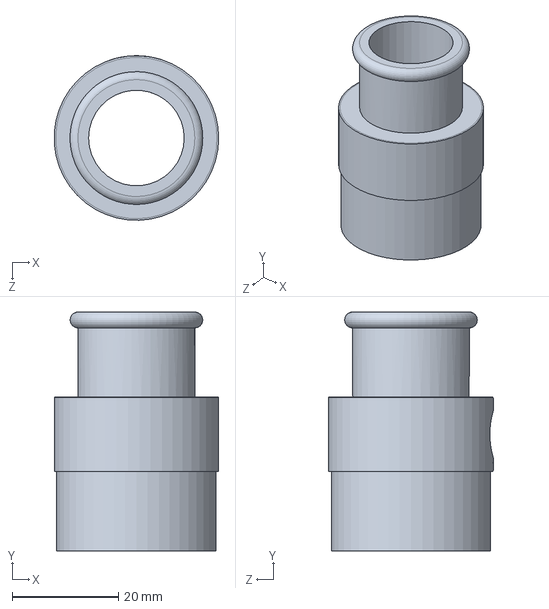
[picture p64: CAD file, 2021-10-17]
files/Acople_Sensor_Presion.SLDPRT
31.0 x 45.0 x 31.0 mm
