rent-a-human/mechanical-ventilator/files/AC Male Socket PC v7.SLDPRT

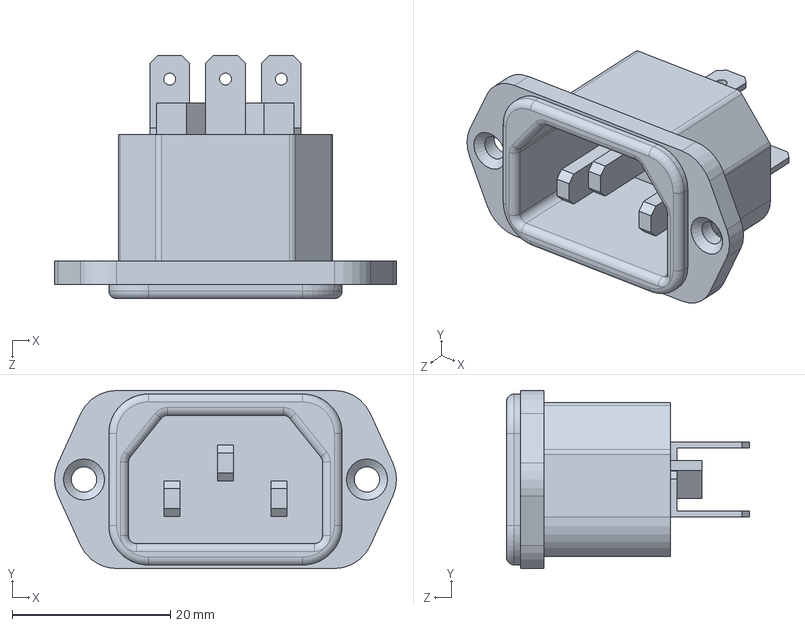
[picture p65: CAD file, 2021-10-17]
files/AC Male Socket PC v7.SLDPRT
43.2 x 22.5 x 30.8 mm
