rent-a-human/mechanical-ventilator/files/Manguera_3.SLDPRT

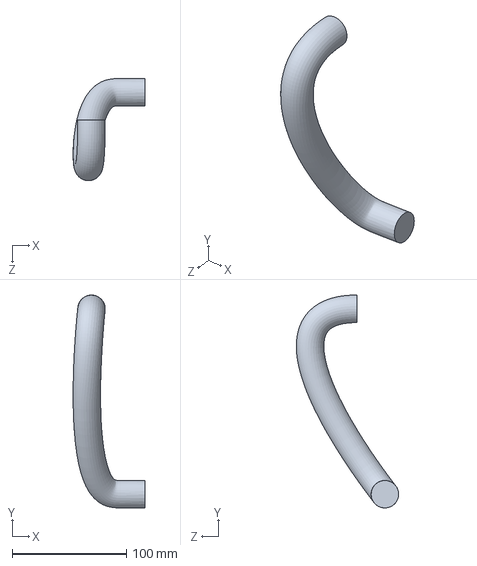
[picture p66: CAD file, 2021-10-17]
files/Manguera_3.SLDPRT
63.0 x 186.8 x 89.8 mm
