rent-a-human/mechanical-ventilator/files/tapa_1.SLDPRT

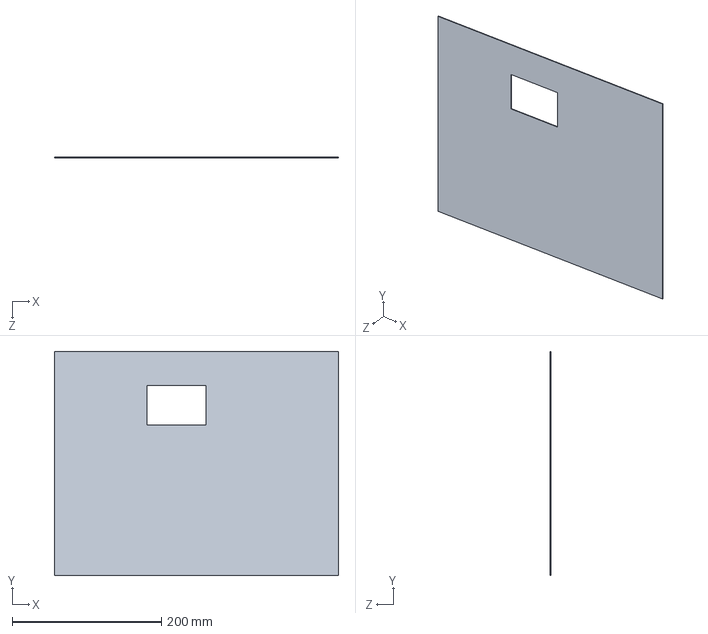
[picture p67: CAD file, 2021-10-17]
files/tapa_1.SLDPRT
380.0 x 300.0 x 1.00 mm
