rent-a-human/mechanical-ventilator/files/ambu.SLDPRT

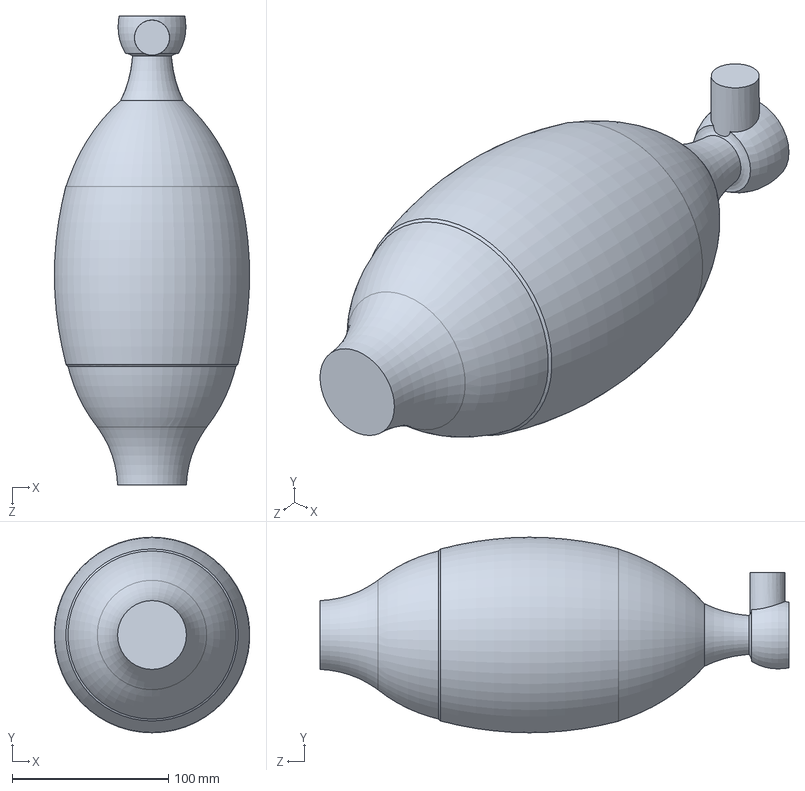
[picture p68: CAD file, 2021-10-17]
files/ambu.SLDPRT
124.9 x 125.1 x 300.0 mm
