rent-a-human/mechanical-ventilator/files/manija.SLDPRT

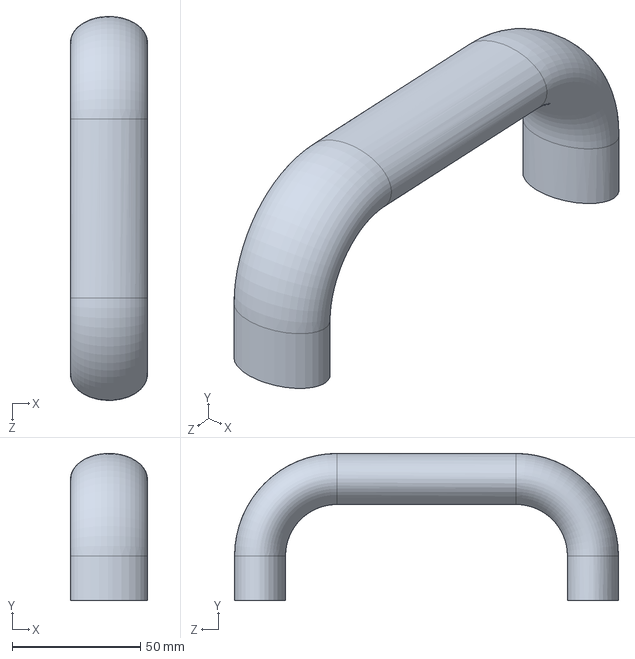
[picture p69: CAD file, 2021-10-17]
files/manija.SLDPRT
30.0 x 57.5 x 150.0 mm
