rent-a-human/mechanical-ventilator/files/base nema34.SLDPRT

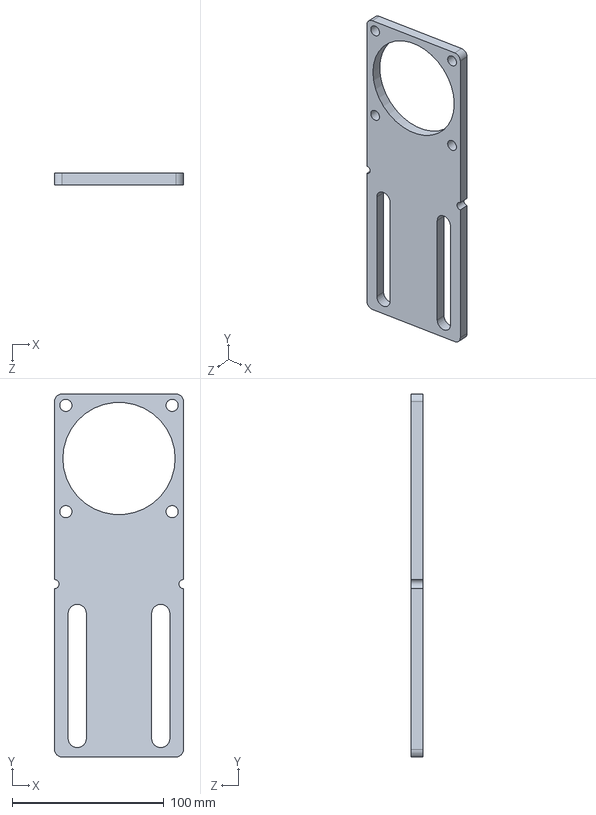
[picture p70: CAD file, 2021-10-17]
files/base nema34.SLDPRT
85.0 x 239.1 x 7.94 mm
