rent-a-human/mechanical-ventilator/files/Manguera1.SLDPRT

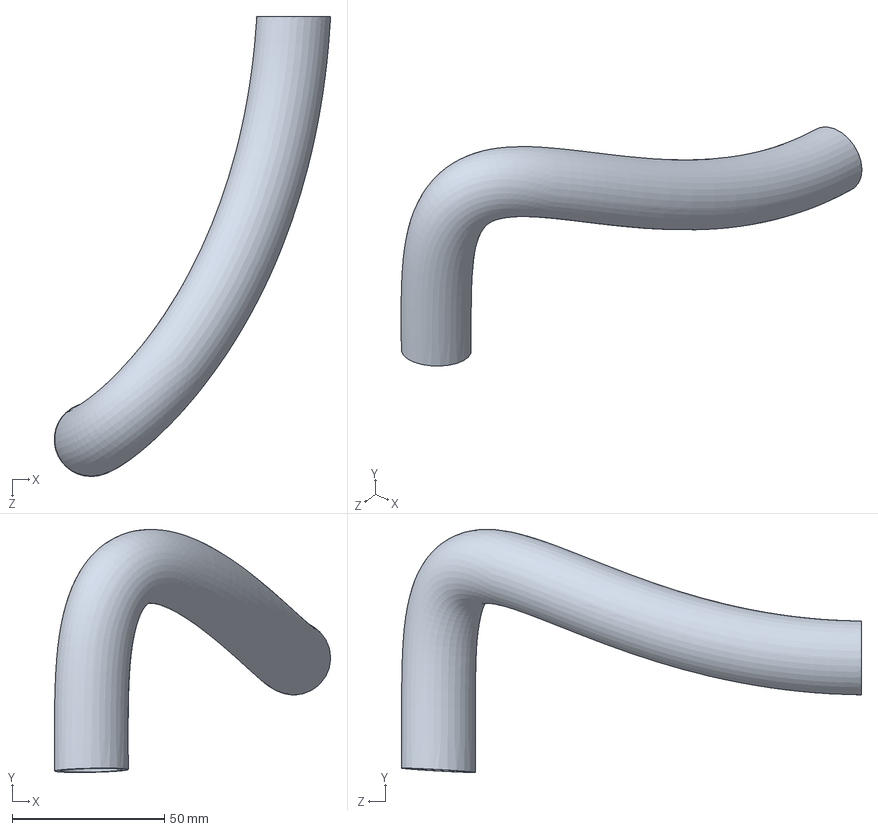
[picture p71: CAD file, 2021-10-17]
files/Manguera1.SLDPRT
90.9 x 79.9 x 151.2 mm
