rent-a-human/mechanical-ventilator/files/acople flexible.SLDPRT

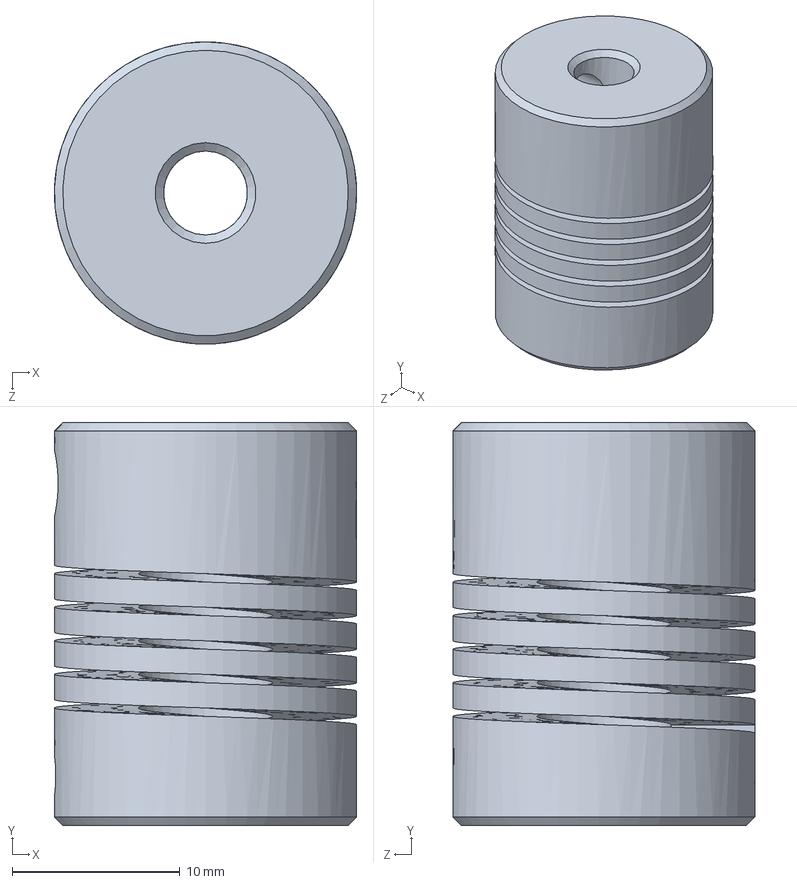
[picture p72: CAD file, 2021-10-17]
files/acople flexible.SLDPRT
18.0 x 24.0 x 18.0 mm
