rent-a-human/mechanical-ventilator/files/reset_buton.SLDPRT

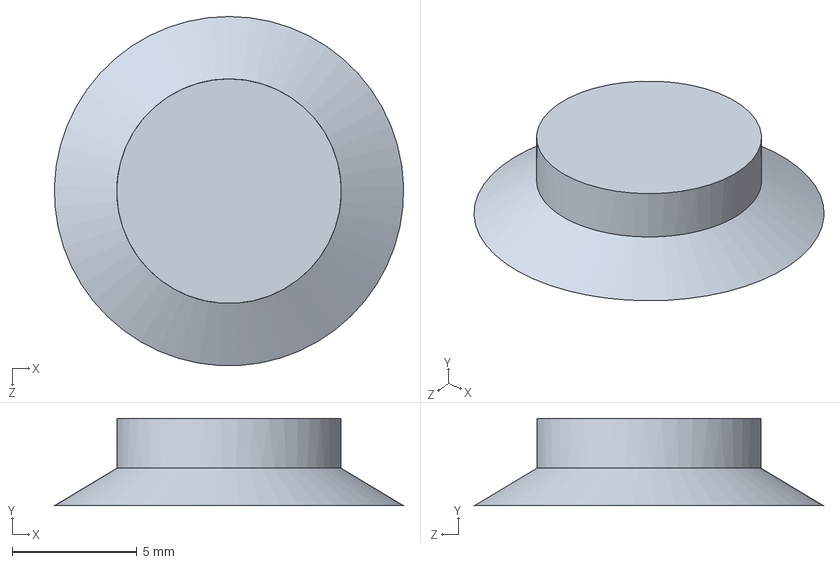
[picture p73: CAD file, 2021-10-17]
files/reset_buton.SLDPRT
14.0 x 3.50 x 14.0 mm
