rent-a-human/mechanical-ventilator/(list of files, cad)

Other CAD files:
files/On off switch pin1.sldprt
files/RESPIRADOR/planos tarjeta/atras.DWG
files/On off switch pin2.sldprt
files/RESPIRADOR/planos tarjeta/huecos-frente.DWG
files/RESPIRADOR/planos tarjeta/atras_solo.DWG
files/tarjeta_circuito.SLDPRT
files/RESPIRADOR/planos tarjeta/adelante.DWG
files/On off switch pin3.sldprt
files/On off switch click.sldprt
files/On off switch base.sldprt
files/pinza inferior.SLDPRT
files/Base1.SLDPRT
files/Manguera Filtro Mascara Paciente.SLDPRT
files/On off switch button.sldprt
files/On off switch spring.sldprt
files/Pinza SAER.SLDDRW
files/RESPIRADOR/planos tarjeta/atras_y_adelante.DWG
files/RESPIRADOR/planos tarjeta/baquela.SLDDRW
files/Trapezoidal lead screw 90mm.SLDPRT
