rent-a-human/mechanical-ventilator/files/Guia_Rapida_SAER.pdf

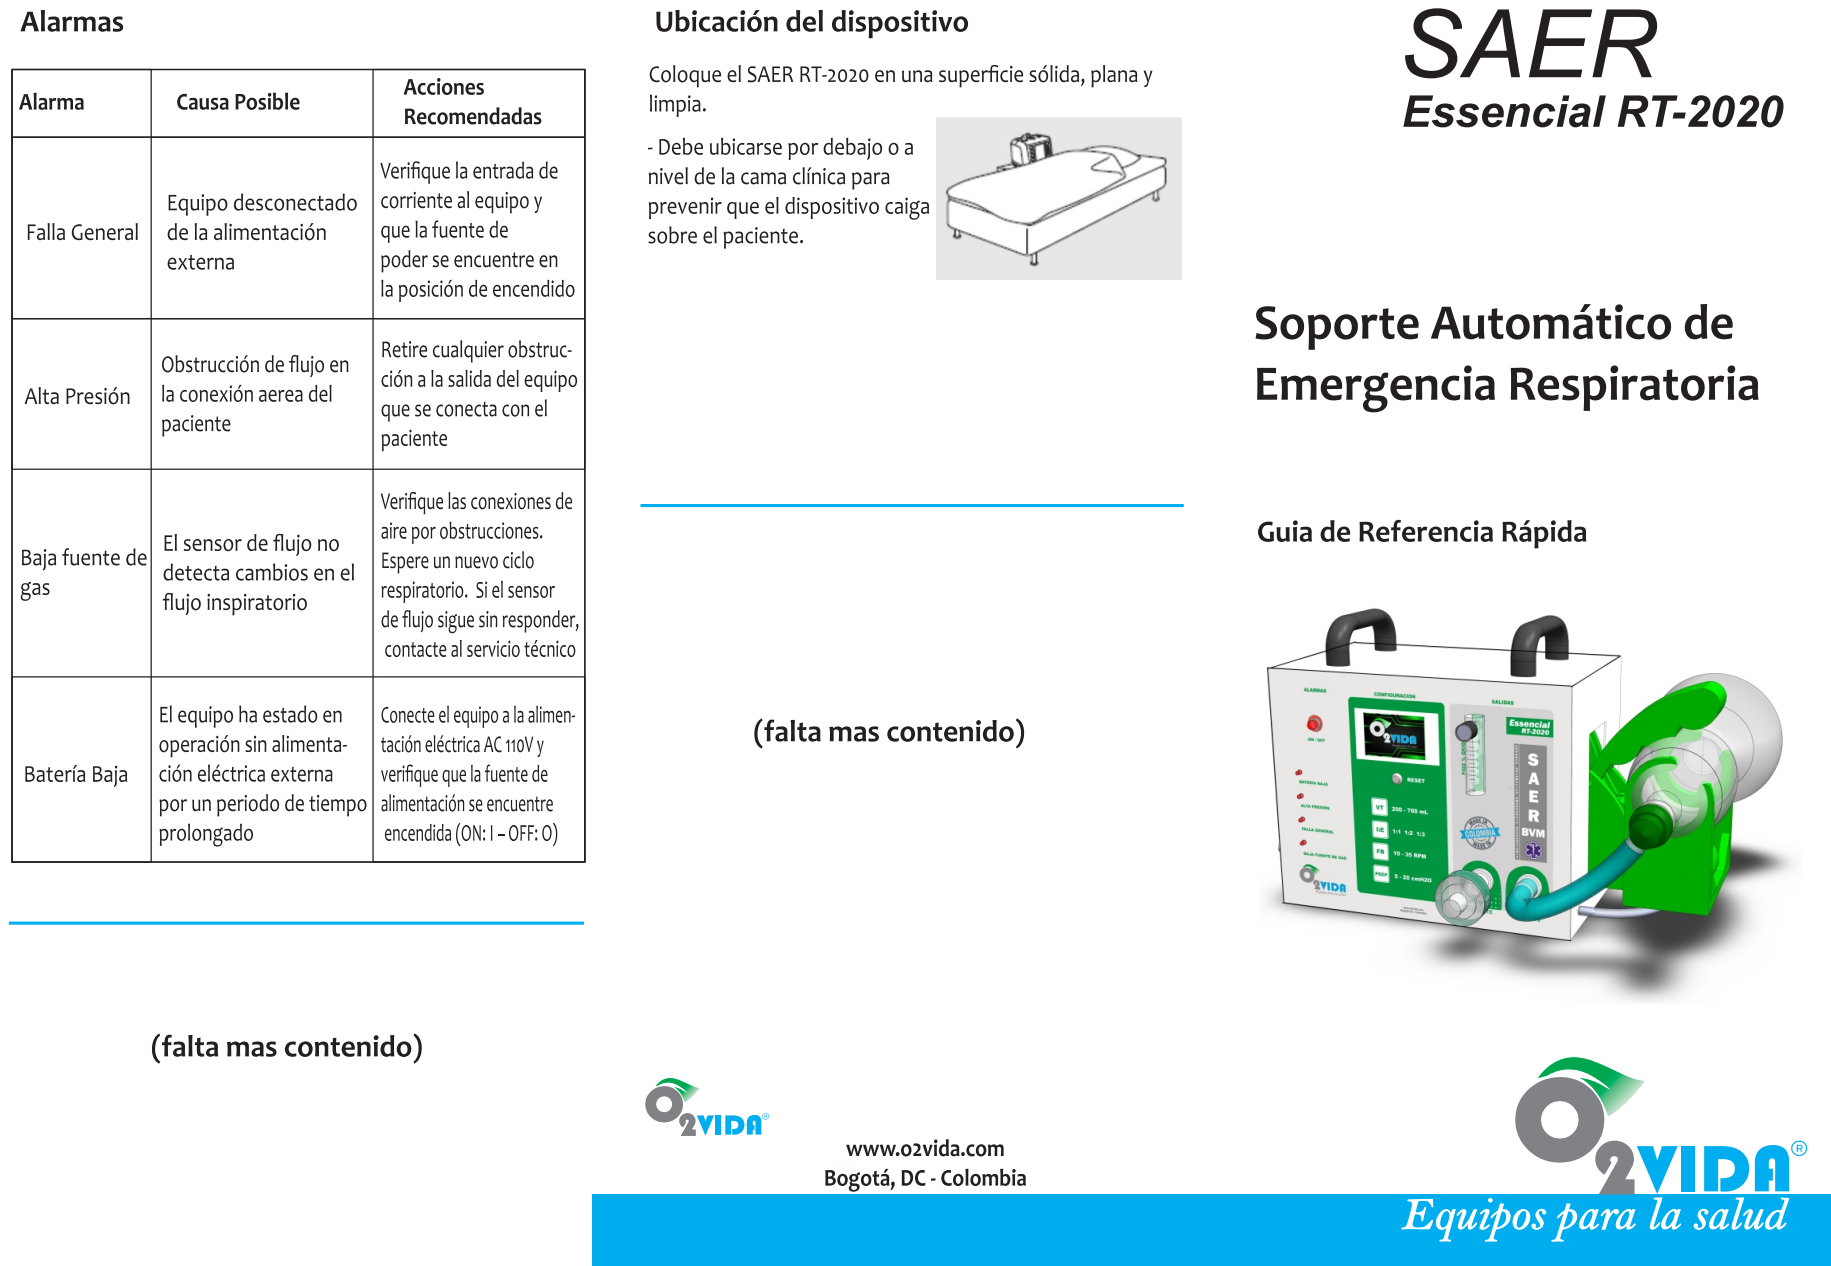
[picture p75: page 1]

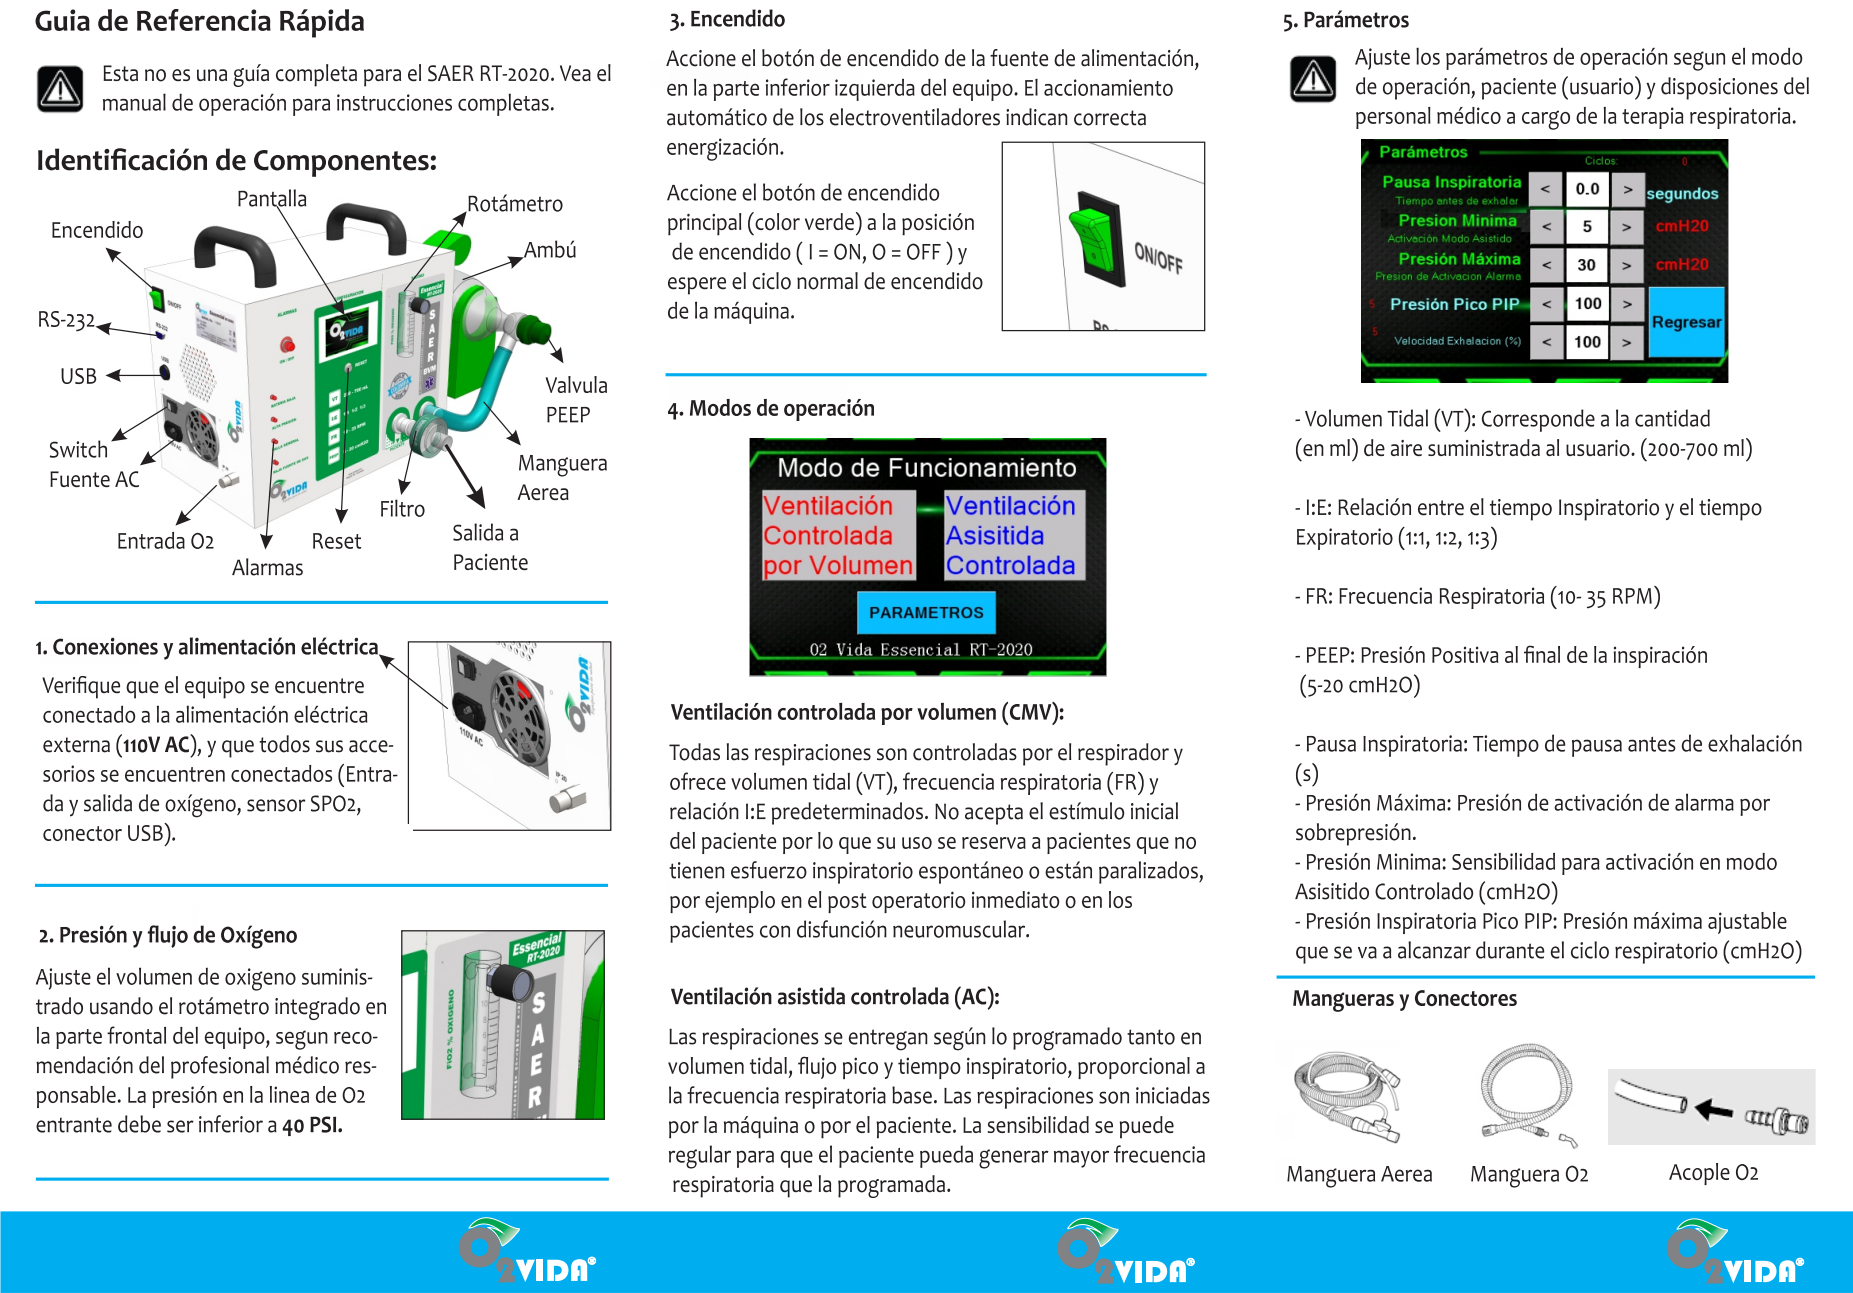
[picture p76: page 2]
