rent-a-human/mechanical-ventilator/files/Pinza SAER.PDF

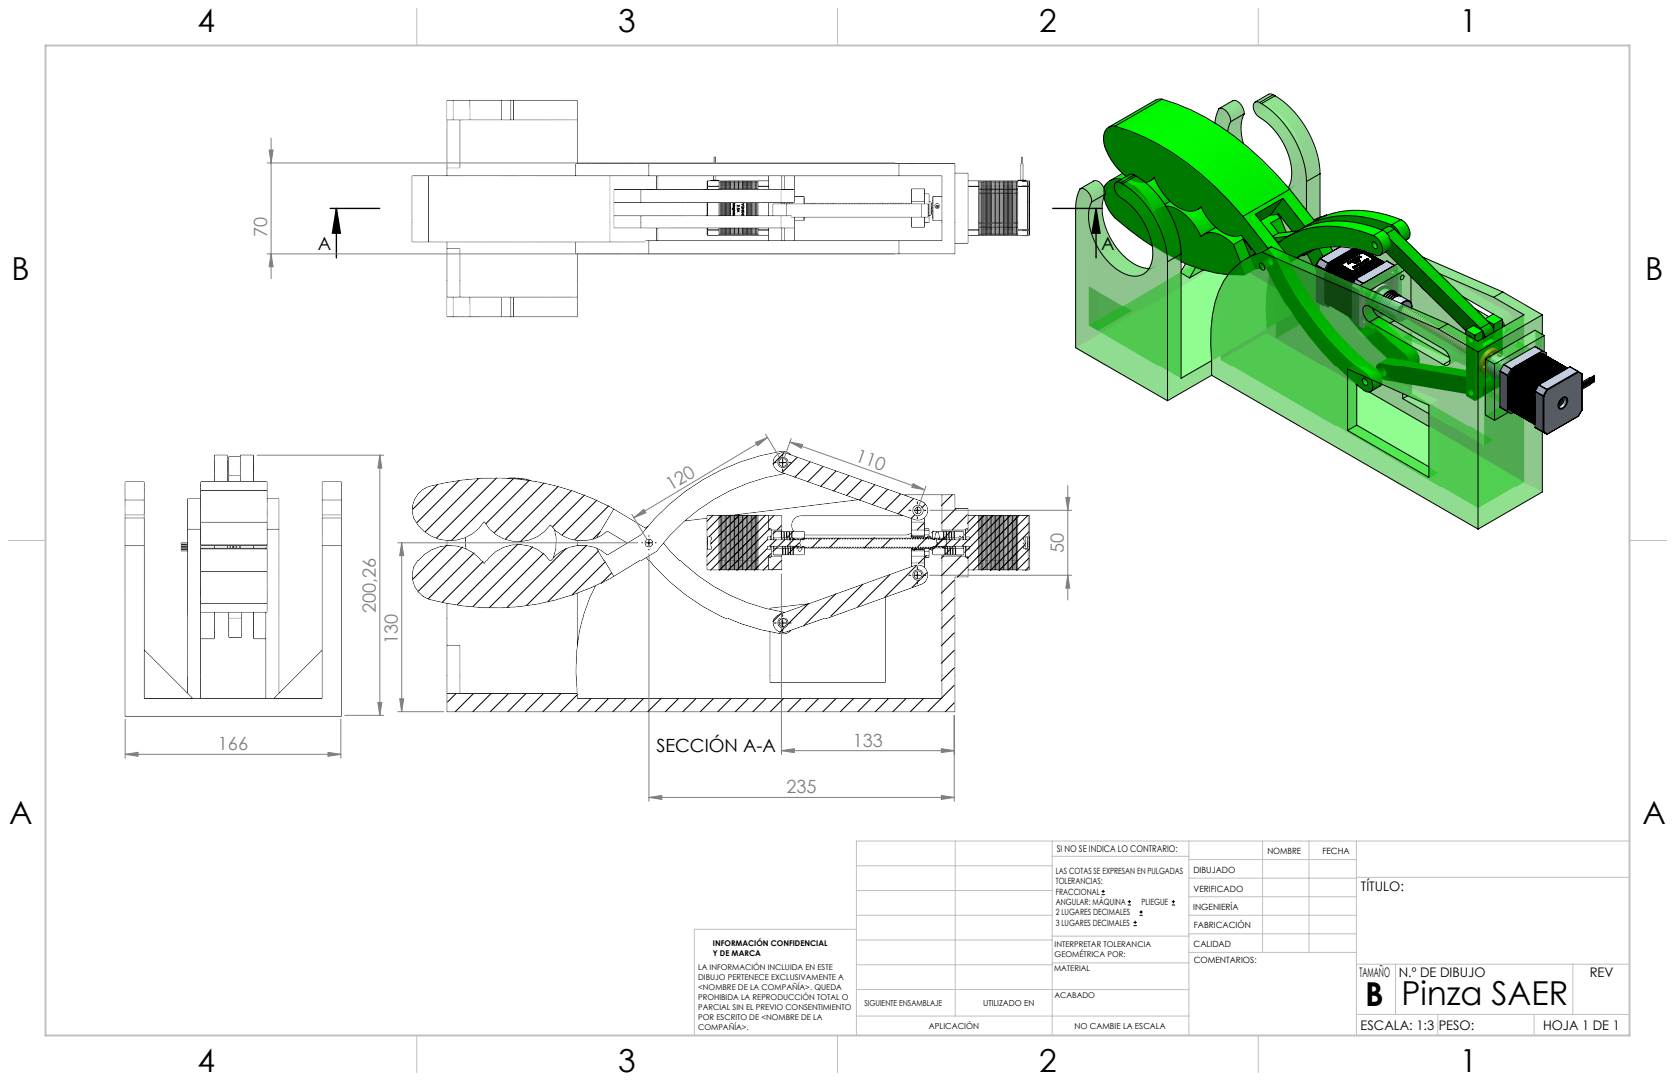
[picture p77: page 1]
133 SECCIÓN A-A

SI NO SE INDICA LO CONTRARIO: | | NOMBRE | FECHA
LAS COTAS SE EXPRESAN EN PULGADAS TOLERANCIAS: FRACCIONAL ANGULAR: MÁQUINA PLIEGUE 2 LUGARES DECIMALES 3 LUGARES DECIMALES | DIBUJADO

VERIFICADO | | | TÍTULO:

INGENIERÍA
FABRICACIÓN

INFORMACIÓN CONFIDENCIAL
Y DE MARCA
LA INFORMACIÓN INCLUIDA EN ESTE
DIBUJO PERTENECE EXCLUSIVAMENTE A
<NOMBRE DE LA COMPAÑÍA>. QUEDA
PROHIBIDA LA REPRODUCCIÓN TOTAL O
PARCIAL SIN EL PREVIO CONSENTIMIENTO
POR ESCRITO DE <NOMBRE DE LA
COMPAÑÍA>.

INTERPRETAR TOLERANCIA GEOMÉTRICA POR: | CALIDAD

MATERIAL | | TAMAÑO B | N.º DE DIBUJO Pinza SAER | REV

SIGUIENTE ENSAMBLAJE | UTILIZADO EN | ACABADO

APLICACIÓN | NO CAMBIE LA ESCALA | | ESCALA: 1:3 PESO: | | HOJA 1 DE 1
