rent-a-human/mechanical-ventilator/files/RESPIRADOR/planos tarjeta/atras.PDF

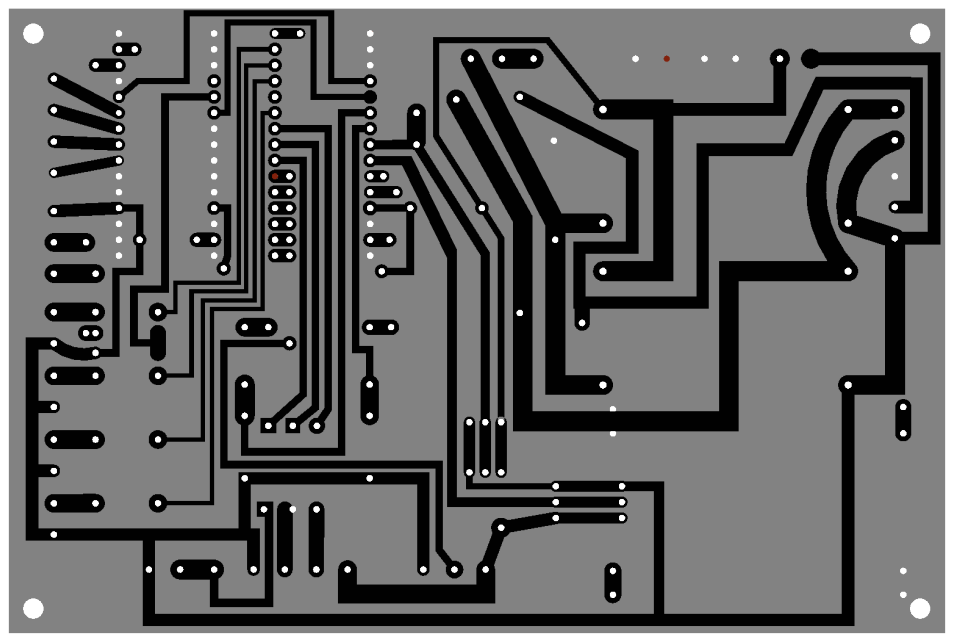
[picture p78: page 1]
