rent-a-human/mechanical-ventilator/files/RESPIRADOR/planos tarjeta/atras_y_adelante.PDF

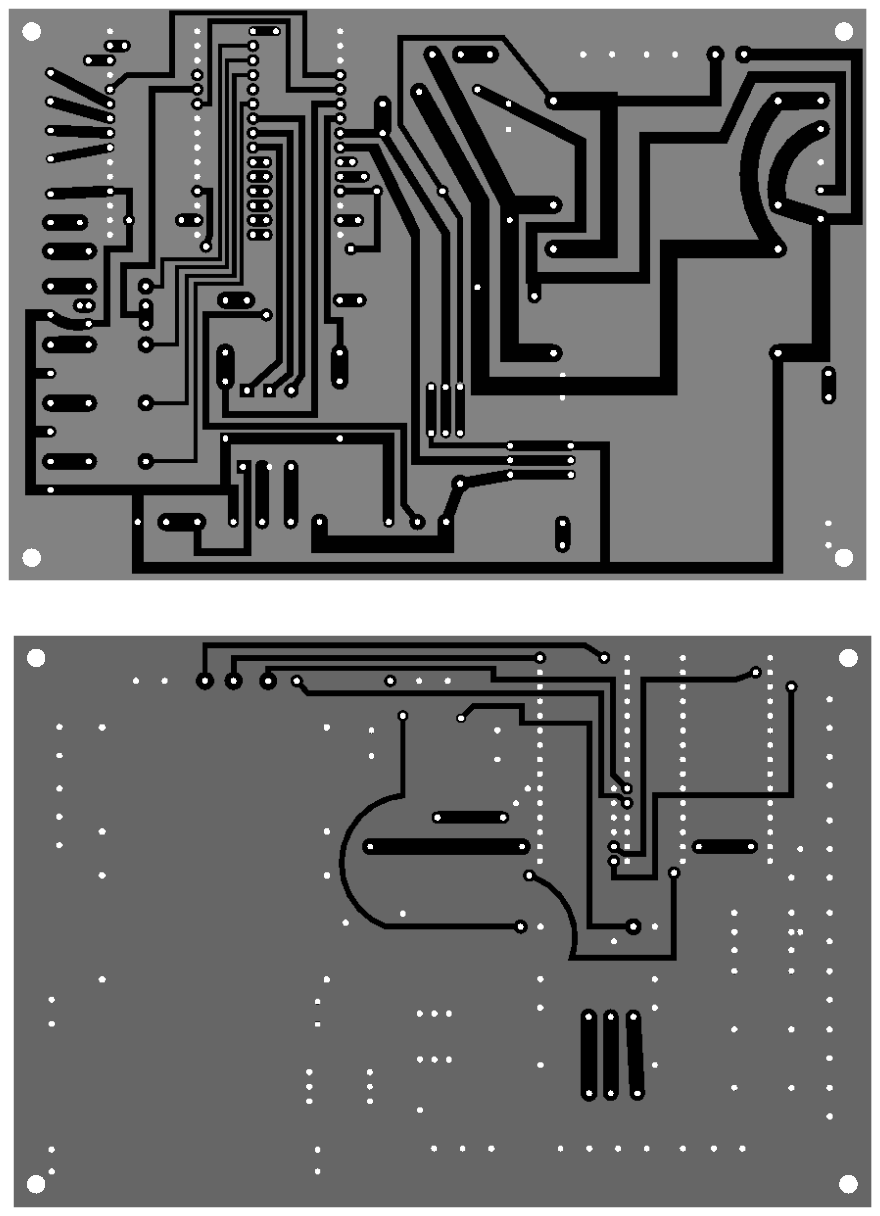
[picture p79: page 1]
