rent-a-human/mechanical-ventilator/files/RESPIRADOR/planos tarjeta/atras_y_adelante_con_cotas.PDF

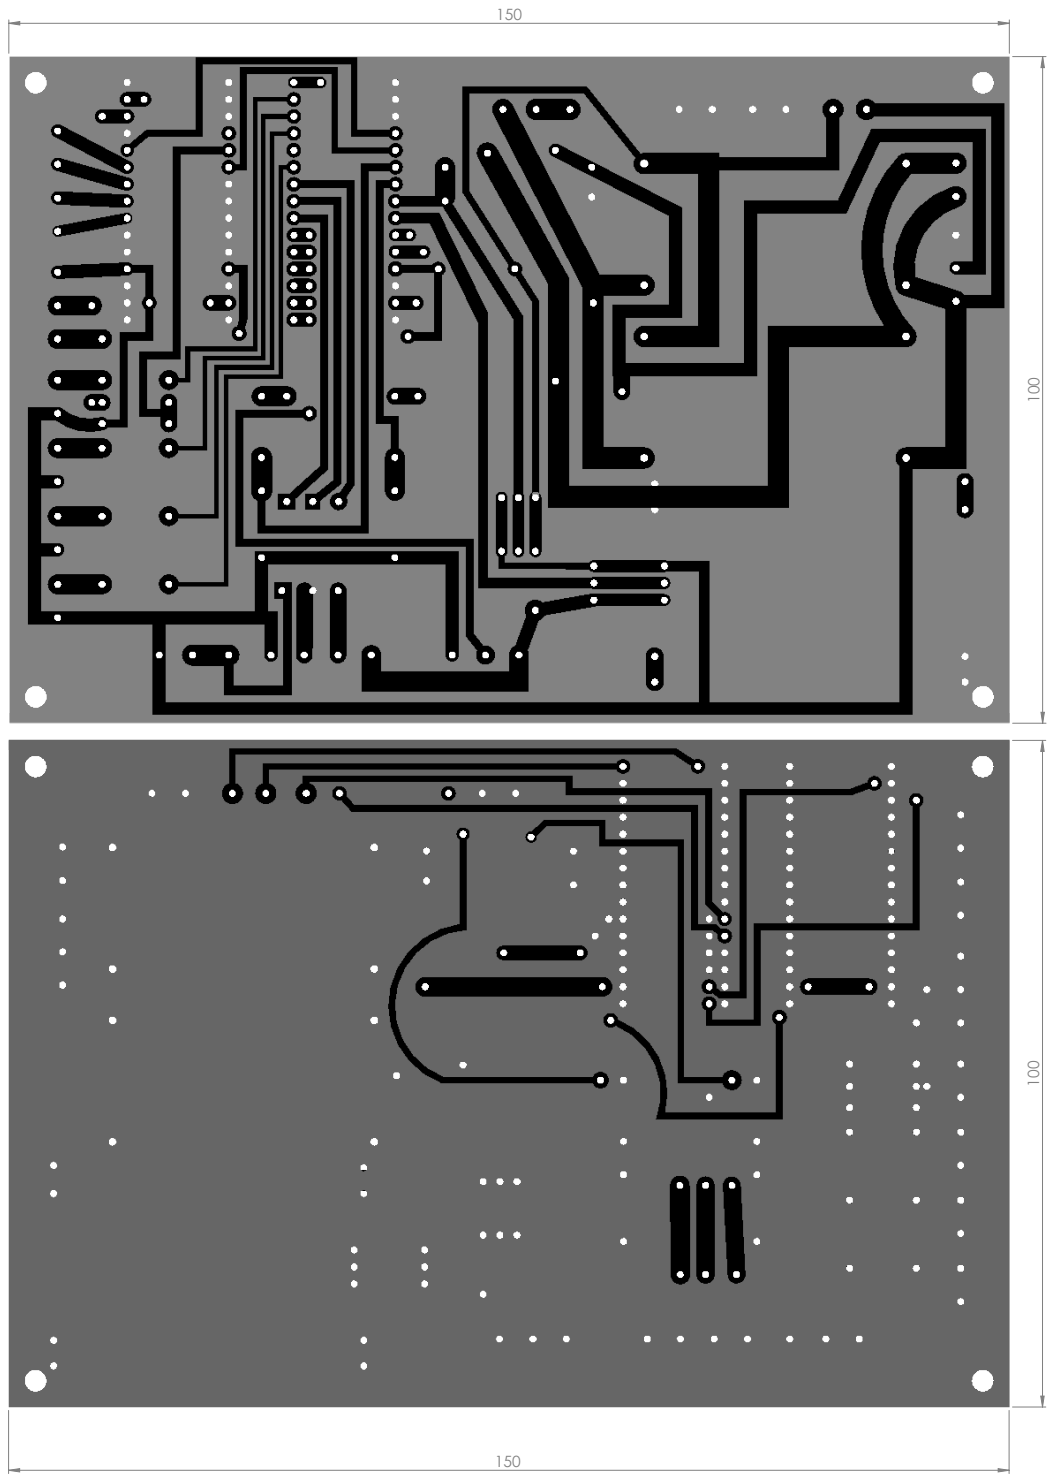
[picture p80: page 1]
