rent-a-human/mechanical-ventilator/files/RESPIRADOR/planos tarjeta/pdf/c1.PDF

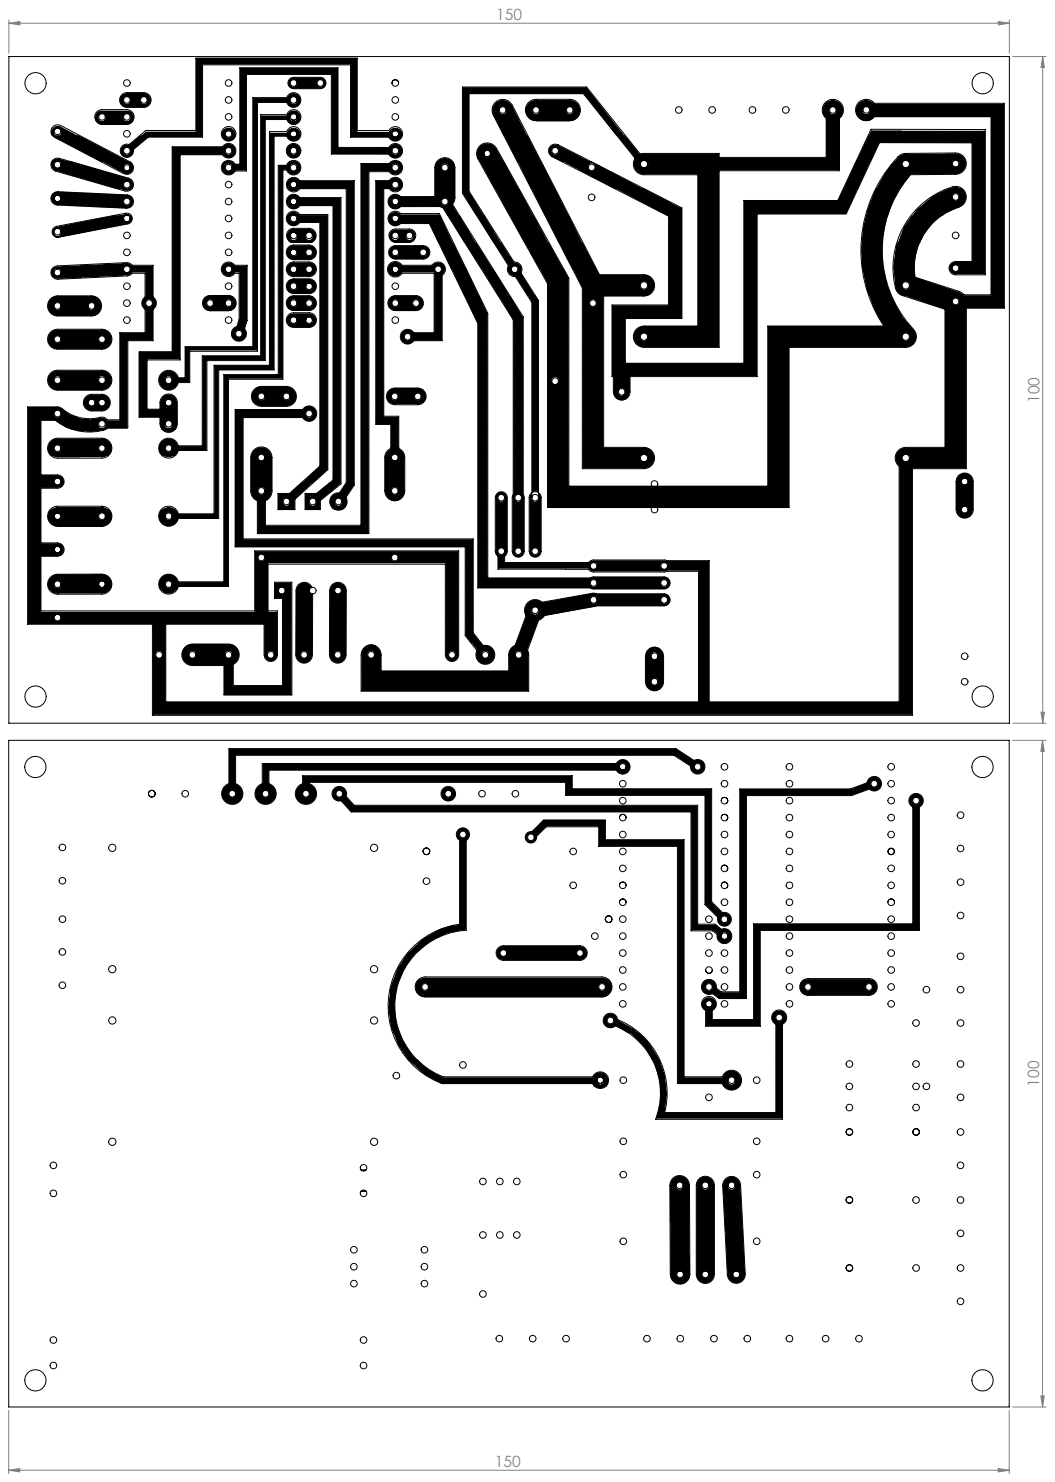
[picture p81: page 1]
