rent-a-human/mechanical-ventilator/(list of files, drawings)

Other design files:
files/RESPIRADOR/respirador/cabina_desinfeccion.pdsprj
files/RESPIRADOR/respirador/RESPIRADORMOD.pdsprj
files/RESPIRADOR/respirador/RESPIRADORMOD_nodemcu.pdsprj
files/RESPIRADOR/RESPIRADORMOD.pdsprj
files/RESPIRADOR/RESPIRADORMOD_nodemcu.pdsprj
