rent-a-human/mechanical-ventilator/files/Arduino/presion/presion.ino

#include "HX711.h"

// HX711 circuit wiring
const int LOADCELL_DOUT_PIN = 12;
const int LOADCELL_SCK_PIN = 3;

HX711 scale;

void setup() {
  Serial.begin(57600);
  scale.begin(LOADCELL_DOUT_PIN, LOADCELL_SCK_PIN);
}

void loop() {
  //map(reading, 850000, 3000000, 5, 67);
  if (scale.is_ready()) {
    long reading = scale.read();
    Serial.print("HX711 reading: ");
    Serial.println(map(reading, 820000, 3200000, 5, 50));
  } else {
    Serial.println("HX711 not found.");
  }

  delay(5);

}
